ricynlee/femto/DEMO/readme.md

# Sound communication demo with femto/声音通信演示

***

This is a demo featuring a modified femto. The demo shows a case of sound communication, with OOK (on-off-keying) modulation.  
这是一个用魔改femto演示音频通信的项目，采用了OOK(开关键控)调制。  

***

Please vide the video below for a general introduction of femto and the demo.  
请点击下面的链接观看femto和演示项目简介。  

[Intro in Chinese/简介](https://www.bilibili.com/video/BV1J44y1s77Q)
