ricynlee/femto/(threads)

Thread 1 (2022-03-06):

Add trap support

ricynlee, 2022-03-06:
**Traps**, arroding to RISC-V privilege spec, are categorized into **interrupts** and **exceptions**, and there are internal/external interrupts.
As *femto* is a minimalist MCU, I think it's perfect to implement external interrupts only.
Faults may lead to a reset or halt.
No internal timer is to be implemented but there will be an external one.

ricynlee, 2022-05-08:
Interrupt support added. No exception support yet. Later debug exception will be implemented, but nothing else.

Closed 2022-05-08.
