ricynlee/femto/rtl/fpga/constraints/io.xdc

## Clock signal 12 MHz
set_property -dict {PACKAGE_PIN L17 IOSTANDARD LVCMOS33} [get_ports sysclk]
# add the timing description above if no clocking modules are used in the design

## NOR PULL
# set_property PULLUP true [get_ports {qspi_sio[3]}]
# set_property PULLUP true [get_ports {qspi_sio[2]}]
# set_property PULLUP true [get_ports {qspi_sio[1]}]
# set_property PULLUP true [get_ports {qspi_sio[0]}]

## QSPI NOR
# set_property -dict {PACKAGE_PIN E19 IOSTANDARD LVCMOS33} [get_ports qspi_sck]
# set_property -dict {PACKAGE_PIN K19 IOSTANDARD LVCMOS33} [get_ports qspi_csb]
# set_property -dict {PACKAGE_PIN D18 IOSTANDARD LVCMOS33} [get_ports {qspi_sio[0]}]
# set_property -dict {PACKAGE_PIN D19 IOSTANDARD LVCMOS33} [get_ports {qspi_sio[1]}]
# set_property -dict {PACKAGE_PIN G18 IOSTANDARD LVCMOS33} [get_ports {qspi_sio[2]}]
# set_property -dict {PACKAGE_PIN F18 IOSTANDARD LVCMOS33} [get_ports {qspi_sio[3]}]

## DSPI NOR
set_property -dict { PACKAGE_PIN H17   IOSTANDARD LVCMOS33 } [get_ports {qspi_sio[0]}]
set_property -dict { PACKAGE_PIN H19   IOSTANDARD LVCMOS33 } [get_ports {qspi_sio[1]}]
set_property -dict { PACKAGE_PIN J19   IOSTANDARD LVCMOS33 } [get_ports qspi_sck]
set_property -dict { PACKAGE_PIN K18   IOSTANDARD LVCMOS33 } [get_ports qspi_csb]
set_property -dict { PACKAGE_PIN G17   IOSTANDARD LVCMOS33 } [get_ports {qspi_sio[2]}]; # place holder
set_property -dict { PACKAGE_PIN G19   IOSTANDARD LVCMOS33 } [get_ports {qspi_sio[3]}]; # place holder

## LEDs
set_property -dict {PACKAGE_PIN B17 IOSTANDARD LVCMOS33} [get_ports led_b]
set_property -dict {PACKAGE_PIN B16 IOSTANDARD LVCMOS33} [get_ports led_g]
set_property -dict {PACKAGE_PIN C17 IOSTANDARD LVCMOS33} [get_ports led_r]
# set_property -dict {PACKAGE_PIN C16 IOSTANDARD LVCMOS33} [get_ports fault]

## Buttons
set_property -dict {PACKAGE_PIN B18 IOSTANDARD LVCMOS33} [get_ports button]
set_property -dict {PACKAGE_PIN A18 IOSTANDARD LVCMOS33} [get_ports sysrst]

## UART
set_property -dict {PACKAGE_PIN J18 IOSTANDARD LVCMOS33} [get_ports uart_tx]
set_property -dict {PACKAGE_PIN J17 IOSTANDARD LVCMOS33} [get_ports uart_rx]

## Cellular RAM
set_property -dict {PACKAGE_PIN M18 IOSTANDARD LVCMOS33} [get_ports {sram_addr[0]}]
set_property -dict {PACKAGE_PIN M19 IOSTANDARD LVCMOS33} [get_ports {sram_addr[1]}]
set_property -dict {PACKAGE_PIN K17 IOSTANDARD LVCMOS33} [get_ports {sram_addr[2]}]
set_property -dict {PACKAGE_PIN N17 IOSTANDARD LVCMOS33} [get_ports {sram_addr[3]}]
set_property -dict {PACKAGE_PIN P17 IOSTANDARD LVCMOS33} [get_ports {sram_addr[4]}]
set_property -dict {PACKAGE_PIN P18 IOSTANDARD LVCMOS33} [get_ports {sram_addr[5]}]
set_property -dict {PACKAGE_PIN R18 IOSTANDARD LVCMOS33} [get_ports {sram_addr[6]}]
set_property -dict {PACKAGE_PIN W19 IOSTANDARD LVCMOS33} [get_ports {sram_addr[7]}]
set_property -dict {PACKAGE_PIN U19 IOSTANDARD LVCMOS33} [get_ports {sram_addr[8]}]
set_property -dict {PACKAGE_PIN V19 IOSTANDARD LVCMOS33} [get_ports {sram_addr[9]}]
set_property -dict {PACKAGE_PIN W18 IOSTANDARD LVCMOS33} [get_ports {sram_addr[10]}]
set_property -dict {PACKAGE_PIN T17 IOSTANDARD LVCMOS33} [get_ports {sram_addr[11]}]
set_property -dict {PACKAGE_PIN T18 IOSTANDARD LVCMOS33} [get_ports {sram_addr[12]}]
set_property -dict {PACKAGE_PIN U17 IOSTANDARD LVCMOS33} [get_ports {sram_addr[13]}]
set_property -dict {PACKAGE_PIN U18 IOSTANDARD LVCMOS33} [get_ports {sram_addr[14]}]
set_property -dict {PACKAGE_PIN V16 IOSTANDARD LVCMOS33} [get_ports {sram_addr[15]}]
set_property -dict {PACKAGE_PIN W16 IOSTANDARD LVCMOS33} [get_ports {sram_addr[16]}]
set_property -dict {PACKAGE_PIN W17 IOSTANDARD LVCMOS33} [get_ports {sram_addr[17]}]
set_property -dict {PACKAGE_PIN V15 IOSTANDARD LVCMOS33} [get_ports {sram_addr[18]}]
set_property -dict {PACKAGE_PIN W15 IOSTANDARD LVCMOS33} [get_ports {sram_data[0]}]
set_property -dict {PACKAGE_PIN W13 IOSTANDARD LVCMOS33} [get_ports {sram_data[1]}]
set_property -dict {PACKAGE_PIN W14 IOSTANDARD LVCMOS33} [get_ports {sram_data[2]}]
set_property -dict {PACKAGE_PIN U15 IOSTANDARD LVCMOS33} [get_ports {sram_data[3]}]
set_property -dict {PACKAGE_PIN U16 IOSTANDARD LVCMOS33} [get_ports {sram_data[4]}]
set_property -dict {PACKAGE_PIN V13 IOSTANDARD LVCMOS33} [get_ports {sram_data[5]}]
set_property -dict {PACKAGE_PIN V14 IOSTANDARD LVCMOS33} [get_ports {sram_data[6]}]
set_property -dict {PACKAGE_PIN U14 IOSTANDARD LVCMOS33} [get_ports {sram_data[7]}]
set_property -dict {PACKAGE_PIN P19 IOSTANDARD LVCMOS33} [get_ports sram_oe_bar]
set_property -dict {PACKAGE_PIN R19 IOSTANDARD LVCMOS33} [get_ports sram_we_bar]
set_property -dict {PACKAGE_PIN N19 IOSTANDARD LVCMOS33} [get_ports sram_ce_bar]
