ricynlee/femto/rtl/fpga/constraints/config.xdc

# configuration related
set_property BITSTREAM.CONFIG.UNUSEDPIN pullnone [current_design]
set_property BITSTREAM.CONFIG.SPI_BUSWIDTH 4 [current_design]
set_property CONFIG_VOLTAGE 3.3 [current_design]
set_property CFGBVS VCCO [current_design]
