ricynlee/femto/rtl/mcu/rst/rst.v

`include "femto.vh"
`include "timescale.vh"

module rst_controller (
    input wire  clk,

    input wire                  rst_ib, // lo active
    output wire[`RST_WIDTH-1:0] rst_ob, // lo active

    input wire            soc_fault,
    input wire[7:0]       soc_fault_cause,
    input wire[`XLEN-1:0] soc_fault_addr,

    input wire[$clog2(`RST_SIZE)-1:0]   addr,
    input wire                          w_rb,
    input wire[`BUS_ACC_WIDTH-1:0]      acc,
    output reg[`BUS_WIDTH-1:0]          rdata,
    input wire[`BUS_WIDTH-1:0]          wdata,
    input wire                          req,
    output wire                         resp,
    output wire                         fault
);
    /*
     * Register map
     *  Name   | Address | Size | Access | Note
     *  RST    | 0       | 2    | W      | -
     *  CAUSE  | 2       | 2    | R      | -
     *  INFO   | 4       | 4    | RW     | Addr upon fault or SW-defined message
     *
     * RST
     *  (15:1) | RESET(0)
     * CAUSE
     *  (15:8) | CAUSE(7:0)
     */

    // fault generation
    wire invld_addr = (addr != 0) && (addr != 2) && (addr != 4);
    wire invld_acc  = (addr==4) ? (acc != `BUS_ACC_4B) : (acc != `BUS_ACC_2B);
    wire invld_wr   = w_rb ? addr[2:1]==2'd1 : addr[2:1]==2'd0;

    wire invld      = |{invld_addr,invld_acc,invld_wr};
    assign fault    = req & invld;

    // rst info
    reg[7:0]       rst_cause = `RST_CAUSE_POR;
    reg[`XLEN-1:0] rst_info;
    always @ (posedge clk) begin
        if (~rst_ib) begin
            rst_cause <= `RST_CAUSE_HW;
            // do not touch rst_info here so sw can set it at key points
            // in this way sw knows at which phase hw rst occurs
        end else if (req && ~invld && w_rb) begin
            if (addr==0 && wdata[0])
                rst_cause <= `RST_CAUSE_SW;
            else if (addr==4)
                rst_info <= wdata;
        end else if (soc_fault) begin
            rst_cause <= soc_fault_cause;
            rst_info <= soc_fault_addr;
        end
    end

    // resp generation
    reg resp_r = 1'b0; // initially no resp (FPGA synthesizable)
    assign resp = resp_r;
    always @ (posedge clk) begin
        resp_r <= req & ~invld;
        if (req & ~invld) begin
            if (addr[1]) // CAUSE
                rdata[15:0] <= {8'd0, rst_cause};
            else if (addr[2]) // INFO
                rdata <= rst_info;
        end
    end

    // reset generation
    reg [`RST_WIDTH-1:0] rst_drv = {`RST_WIDTH{1'b0}}; // initially POR (FPGA synthesizable)
    assign rst_ob = rst_drv;

    always @ (posedge clk) begin
        if (~rst_ib) begin // external reset input: highest priority
            rst_drv <= {`RST_WIDTH{1'b0}};
        end else if (req && ~invld && w_rb && addr==0 && wdata[0]) begin
            rst_drv <= {`RST_WIDTH{1'b0}};
        end else if (soc_fault) begin
            rst_drv <= {`RST_WIDTH{1'b0}};
        end else begin
            rst_drv <= {`RST_WIDTH{1'b1}};
        end
    end
endmodule
