ricynlee/femto/project/femto.srcs/sources_1/ip/clk_gen/clk_gen_stub.v

// Copyright 1986-2018 Xilinx, Inc. All Rights Reserved.
// --------------------------------------------------------------------------------
// Tool Version: Vivado v.2018.2 (win64) Build 2258646 Thu Jun 14 20:03:12 MDT 2018
// Date        : Sat Oct  9 16:08:51 2021
// Host        : NXL53319 running 64-bit major release  (build 9200)
// Command     : write_verilog -force -mode synth_stub D:/femto/project/femto.srcs/sources_1/ip/clk_gen/clk_gen_stub.v
// Design      : clk_gen
// Purpose     : Stub declaration of top-level module interface
// Device      : xc7a35tcpg236-1
// --------------------------------------------------------------------------------

// This empty module with port declaration file causes synthesis tools to infer a black box for IP.
// The synthesis directives are for Synopsys Synplify support to prevent IO buffer insertion.
// Please paste the declaration into a Verilog source file or add the file as an additional source.
module clk_gen(clk_out, clk_in)
/* synthesis syn_black_box black_box_pad_pin="clk_out,clk_in" */;
  output clk_out;
  input clk_in;
endmodule
