ricynlee/femto/rtl/sim/periph/MX25U51245G.v

// *============================================================================================== 
// *
// *   MX25U51245G.v - 512M-BIT CMOS Serial Flash Memory
// *
// *           COPYRIGHT 2021 Macronix International Co., Ltd.
// *
// * Security Level: Macronix Proprietary
// *----------------------------------------------------------------------------------------------
// * Environment  : Cadence NC-Verilog
// * Reference Doc: MX25U51245G REV.1.3,JUL.17,2020
// * Creation Date: @(#)$Date: 2021/06/08 10:50:57 $
// * Version      : @(#)$Revision: 1.17 $
// * Description  : There is only one module in this file
// *                module MX25U51245G->behavior model for the 512M-Bit flash
// *----------------------------------------------------------------------------------------------
// * Note 1:model can load initial flash data from file when parameter Init_File = "xxx" was defined; 
// *        xxx: initial flash data file name;default value xxx = "none", initial flash data is "FF".
// * Note 2:power setup time is tVSL = 1500_000 ns, so after power up, chip can be enable.
// * Note 3:because it is not checked during the Board system simulation the tCLQX timing
// *        is not inserted to the read function flow temporarily.
// * Note 4:more than one values (min. typ. max. value) are defined for some AC parameters in the
// *        datasheet, but only one of them is selected in the behavior model, e.g. program and
// *        erase cycle time is typical value. For the detailed information of the parameters,
// *        please refer to datasheet and contact with Macronix.
// * Note 5:If you have any question and suggestion, please send your mail to following email address :
// *                                    flash_model@mxic.com.tw
// *============================================================================================== 
// * timescale define
// *============================================================================================== 
`timescale 1ns / 100ps

`define MX25U51245GM 16SOP
//`define MX25U51245GZ4 8WSON
//`define MX25U51245GXD 24BALL


// *============================================================================================== 
// * product parameter define
// *============================================================================================== 

    /*----------------------------------------------------------------------*/
    /* all the parameters users may need to change                          */
    /*----------------------------------------------------------------------*/
        `define Type_0A  //for  non-password protection mode
        //`define Type_00  //for password protection mode

        `define File_Name         "none"         // Flash data file name for normal array
        `define File_Name_Secu    "none"         // Flash data file name for security region
        `define File_Name_SFDP    "none"         // Flash data file name for SFDP region
        `define VSecur_Reg1_0     2'b00          // security register[1:0]
        `define VSecur_Reg7       1'b0           // security register[7]
        `define VStatus_Reg7_2    6'b0           // status register[7:2] are non-volatile bits
        `define VLock_Reg         16'hffff       // lock register
        `define CR_Default4_0     5'b00111       // configuration register default value
        `define VPwd_Reg          64'hffff_ffff_ffff_ffff           // password register
        `define VFB_Reg           32'hffff_ffff  // fast boot register

        `ifdef MX25U51245GM
                `define Vtclqv 6    //30pf:8ns, 15pf:6ns, 10pf:5ns.
        `elsif MX25U51245GZ4
                `define Vtclqv 6  //30pf:8ns, 15pf:6ns, 10pf:5ns.
        `elsif MX25U51245GXD
                `define Vtclqv 5  //30pf:5ns, 15pf:5ns, 10pf:5ns.
        `endif
    /*----------------------------------------------------------------------*/
    /* Define controller STATE                                              */
    /*----------------------------------------------------------------------*/
        `define         STANDBY_STATE           0
        `define         CMD_STATE               1
        `define         BAD_CMD_STATE           2
        `define         FAST_BOOT_STATE         3

module MX25U51245G( SCLK, 
                    CS, 
                    SI, 
                    SO, 
                    WP, 
`ifdef MX25U51245GM
                    RESET,
`elsif MX25U51245GXD
                    RESET,
`endif
                    SIO3 );

// *============================================================================================== 
// * Declaration of ports (input, output, inout)
// *============================================================================================== 
    input  SCLK;    // Signal of Clock Input
    input  CS;      // Chip select (Low active)
    inout  SI;      // Serial Input/Output SIO0
    inout  SO;      // Serial Input/Output SIO1
    inout  WP;      // Hardware write protection or Serial Input/Output SIO2
`ifdef MX25U51245GM
    input  RESET;   // Hardware Reset Pin, Active Low
`elsif MX25U51245GXD
    input  RESET;   // Hardware Reset Pin, Active Low
`endif
    inout  SIO3;    // Serial Input/Output SIO3

// *============================================================================================== 
// * Declaration of parameter (parameter)
// *============================================================================================== 
    /*----------------------------------------------------------------------*/
    /* Density STATE parameter                                              */                  
    /*----------------------------------------------------------------------*/
    parameter   A_MSB           = 25,            
                TOP_Add         = 26'h1ff,
                A_MSB_OTP       = 9,                
                Secur_TOP_Add   = 10'h3ff,
                Sector_MSB      = 13,
                A_MSB_SFDP      = 8,
                SFDP_TOP_Add    = 9'h1ff,
                Buffer_Num      = 256,
                Block_MSB       = 9,
                Block_NUM       = 1024;
  
    /*----------------------------------------------------------------------*/
    /* Define ID Parameter                                                  */
    /*----------------------------------------------------------------------*/
    parameter   ID_MXIC         = 8'hc2,
                ID_Device       = 8'h3a,
                Memory_Type     = 8'h25,
                Memory_Density  = 8'h3a;

    /*----------------------------------------------------------------------*/
    /* Define Initial Memory File Name                                      */
    /*----------------------------------------------------------------------*/
    parameter   Init_File       = `File_Name;      // initial flash data
    parameter   Init_File_Secu  = `File_Name_Secu; // initial flash data for security
    parameter   Init_File_SFDP  = `File_Name_SFDP;  // initial flash data for SFDP

    /*----------------------------------------------------------------------*/
    /* AC Characters Parameter                                              */
    /*----------------------------------------------------------------------*/
    parameter   tSHQZ           = 8,        // CS High to SO Float Time [ns]
                tCLQV           = `Vtclqv,  // Clock Low to Output Valid
                tCLQX           = 1,        // Output hold time
                tCEH            = 20,         // CS# high time after program
                tPGBUF_RST      = 40,   // Page buffer reset time
                tBP             = 25_000,      //  Byte program time
                tSE             = 25_000_000,      // Sector erase time  
                tBE             = 220_000,      // Block erase time
                tBE32           = 150_000_000,    // Block 32KB erase time
                tCE             = 150_000,      // unit is ms instead of ns  
                tPP             = 150_000,      // Program time
                tWR_END         = 2_000,          // the time of write operation going to end, suspend not work 
                tW              = 40_000_000,       // Write Status time 
                tWPS            = 25_000,     // Write Protection Select time
                tWREAW          = 40,   // Write extended address register time
                tWRFBR          = 25_000,   // Write fast boot register time
                tWRPASS         = 25_000,  // Write password register time
                tPASSULK        = 2_000, // Right password check time
                tPASSULK_FAIL   = 150_000,    // Password check fail waiting time
                tREADY2_P       = 310_000,  // hardware reset recovery time for pgm
                tREADY2_SE      = 12_000_000,  // hardware reset recovery time for sector ers
                tREADY2_BE      = 25_000_000,  // hardware reset recovery time for block ers
                tREADY2_CE      = 1000_000_000,  // hardware reset recovery time for chip ers
                tREADY2_R       = 40_000,  // hardware reset recovery time for read
                tREADY2_D       = 40_000,  // hardware reset recovery time for instruction decoding phase
                tREADY2_W       = 40_000_000,  // hardware reset recovery time for WRSR
                tVSL            = 5;     // Time delay to chip select allowed

    parameter   tPGM_CHK        = 2_000,   // 2 us
                tERS_CHK        = 100_000;   // 100 us
    parameter   tESL            = 25_000,       // delay after sector erase suspend command
                tPSL            = 25_000,       // delay after sector program suspend command
                tPRS            = 100_000,      // latency between program resume and next suspend
                tERS            = 400_000;      // latency between erase resume and next suspend

    /*----------------------------------------------------------------------*/
    /* Internal counter parameter                                           */
    /*----------------------------------------------------------------------*/
    parameter  Clock             = 50,      // Internal clock cycle = 100ns
               ERS_Count_BE32K   = tBE32 / (Clock*2) / 20,   // Internal clock cycle = 2us
               ERS_Count_SE      = tSE / (Clock*2) / 20,     // Internal clock cycle = 2us
               ERS_Count_BE      = tBE / (Clock*2) / 20,     // Internal clock cycle = 2us
               Echip_Count       = tCE  / (Clock*2) * 2000; 


    specify
        specparam   tSCLK   = 6,    // Clock Cycle Time [ns]
                    fSCLK   = 166,    // Clock Frequence except READ instruction
                    tRSCLK  = 15.2,   // Clock Cycle Time for READ instruction
                    fRSCLK  = 66,   // Clock Frequence for READ instruction
                    tCH     = 2.71,      // Clock High Time (min) [ns]
                    tCL     = 2.71,      // Clock Low  Time (min) [ns]
                    tCH_R   = 7,      // Clock High Time (min) [ns]
                    tCL_R   = 7,      // Clock Low  Time (min) [ns]
                    tCH_4PP = 2.71,      // Clock High Time (min) [ns]
                    tCL_4PP = 2.71,      // Clock Low  Time (min) [ns]
                    tSLCH   = 3,    // CS# Active Setup Time (relative to SCLK) (min) [ns]
                    tCHSL   = 4,    // CS# Not Active Hold Time (relative to SCLK)(min) [ns]
                    tSHSL_R = 7,    // CS High Time for read instruction (min) [ns]
                    tSHSL_W = 30,    // CS High Time for write instruction (min) [ns]
                    tDVCH   = 2,    // SI Setup Time (min) [ns]
                    tCHDX   = 2,    // SI Hold  Time (min) [ns]
                    tCHSH   = 3,    // CS# Active Hold Time (relative to SCLK) (min) [ns]
                    tSHCH   = 3,    // CS# Not Active Setup Time (relative to SCLK) (min) [ns]
                    tWHSL   = 20,    // Write Protection Setup Time                
                    tSHWL   = 100,    // Write Protection Hold  Time
   
                    tTSCLK  = 11.9,    // Clock Cycle Time for 2XI/O READ instruction
                    tTSCLK2 = 9.6,    // Clock Cycle Time for 2XI/O READ instruction
                    tTSCLK3 = 7.5,    // Clock Cycle Time for 2XI/O READ instruction
                    tTSCLK4 = 6.0,    // Clock Cycle Time for 2XI/O READ instruction
                    fTSCLK  = 84,    // Clock Frequence for 2XI/O READ instruction
                    fTSCLK2 = 104,    // Clock Frequence for 2XI/O READ instruction
                    fTSCLK3 = 133,    // Clock Frequence for 2XI/O READ instruction
                    fTSCLK4 = 166,    // Clock Frequence for 2XI/O READ instruction

                    tQSCLK  = 11.9,    // Clock Cycle Time for 4XI/O READ instruction
                    tQSCLK2 = 14.3,    // Clock Cycle Time for 4XI/O READ instruction
                    tQSCLK3 = 9.6,    // Clock Cycle Time for 4XI/O READ instruction
                    tQSCLK4 = 7.5,    // Clock Cycle Time for 4XI/O READ instruction
                    fQSCLK  = 84,    // Clock Frequence for 4XI/O READ instruction
                    fQSCLK2 = 70,  // Clock Frequence for 4XI/O READ instruction
                    fQSCLK3 = 104,  // Clock Frequence for 4XI/O READ instruction
                    fQSCLK4 = 133,  // Clock Frequence for 4XI/O READ instruction

                    tFSCLK   = 7.5,    // Clock Cycle Time for FASTREAD instruction
                    tFSCLK2  = 7.5,    // Clock Cycle Time for FASTREAD instruction
                    tFSCLK3  = 7.5,    // Clock Cycle Time for FASTREAD instruction
                    tFSCLK4  = 6.0,    // Clock Cycle Time for FASTREAD instruction
                    fFSCLK   = 133,   // Clock Frequence for FASTREAD instruction
                    fFSCLK2  = 133,   // Clock Frequence for FASTREAD instruction
                    fFSCLK3  = 133,   // Clock Frequence for FASTREAD instruction
                    fFSCLK4  = 166,   // Clock Frequence for FASTREAD instruction

                    tFDSCLK   = 7.5,    // Clock Cycle Time for DREAD instruction
                    tFDSCLK2  = 7.5,    // Clock Cycle Time for DREAD instruction
                    tFDSCLK3  = 7.5,    // Clock Cycle Time for DREAD instruction
                    tFDSCLK4  = 6.0,    // Clock Cycle Time for DREAD instruction
                    fFDSCLK   = 133,   // Clock Frequence for DREAD instruction
                    fFDSCLK2  = 133,   // Clock Frequence for DREAD instruction
                    fFDSCLK3  = 133,   // Clock Frequence for DREAD instruction
                    fFDSCLK4  = 166,   // Clock Frequence for DREAD instruction

                    tFQSCLK   = 7.5,    // Clock Cycle Time for QREAD instruction
                    tFQSCLK2  = 9.6,    // Clock Cycle Time for QREAD instruction
                    tFQSCLK3  = 7.5,    // Clock Cycle Time for QREAD instruction
                    tFQSCLK4  = 6.0,    // Clock Cycle Time for QREAD instruction
                    fFQSCLK   = 133,    // Clock Frequence for QREAD instruction
                    fFQSCLK2  = 104,   // Clock Frequence for QREAD instruction
                    fFQSCLK3  = 133,   // Clock Frequence for QREAD instruction
                    fFQSCLK4  = 166,   // Clock Frequence for QREAD instruction

                    tQDTRSCLK   = 19.2,    // Clock Cycle Time for FASTDDR4READ instruction
                    tQDTRSCLK2   = 23.8,    // Clock Cycle Time for FASTDDR4READ instruction
                    tQDTRSCLK3   = 15.1,    // Clock Cycle Time for FASTDDR4READ instruction
                    tQDTRSCLK4   = 9.8,    // Clock Cycle Time for FASTDDR4READ instruction
                    fQDTRSCLK   = 52,   // Clock Frequence for FASTDDR4READ instruction
                    fQDTRSCLK2   = 42,   // Clock Frequence for FASTDDR4READ instruction
                    fQDTRSCLK3   = 66,   // Clock Frequence for FASTDDR4READ instruction
                    fQDTRSCLK4   = 102,   // Clock Frequence for FASTDDR4READ instruction

                    tFBSCLK   = 14.3,    // Clock Cycle Time for Fast Boot Read 
                    tFBSCLK2  = 11.9,   // Clock Cycle Time for Fast Boot Read 
                    tFBSCLK3  = 9.6,   // Clock Cycle Time for Fast Boot Read 
                    tFBSCLK4  = 7.5,   // Clock Cycle Time for Fast Boot Read
                    fFBSCLK   = 70,    // Clock Frequence for Fast Boot Read 
                    fFBSCLK2  = 84,   // Clock Frequence for Fast Boot Read 
                    fFBSCLK3  = 104,   // Clock Frequence for Fast Boot Read 
                    fFBSCLK4  = 133,   // Clock Frequence for Fast Boot Read 

                    tRLRH   = 10_000,   // hardware reset pulse
                    tRS     = 15,     // reset setup time
                    tRH     = 15,     // reset hold time
                    tRHSL   = 10_000,  // RESET# high before CS# low
                    tDP     = 10_000,
                    tRES1   = 30_000,
                    tRES2   = 30_000;

     endspecify

    /*----------------------------------------------------------------------*/
    /* Define Command Parameter                                             */
    /*----------------------------------------------------------------------*/
    parameter   WREN        = 8'h06, // WriteEnable   
                WRDI        = 8'h04, // WriteDisable  
                RDSR        = 8'h05, // ReadStatus
                RDCR        = 8'h15, // read configuration register       
                WRSR        = 8'h01, // WriteStatus
                RDID        = 8'h9F, // ReadID
                RES         = 8'hab, // ReadElectricID
                REMS        = 8'h90, // ReadElectricManufacturerDeviceID
                QPIID       = 8'haf, // QPI ID read
                SFDP_READ   = 8'h5a, // enter SFDP read mode
                ENSO        = 8'hb1, // Enter secured OTP;
                EXSO        = 8'hc1, // Exit  secured OTP;
                READ1X      = 8'h03, // ReadData
                READ4B      = 8'h13, // ReadData by 4 byte address
                FASTREAD1X  = 8'h0b, // FastReadData
                FASTREAD4B  = 8'h0c, // FastReadData by 4 byte address
                READ2X      = 8'hbb, // 2X Read
                READ2X4B    = 8'hbc, // 2X Read by 4 byte address
                DREAD       = 8'h3b, // Fastread dual output;
                DREAD4B     = 8'h3c, // Fastread dual output by 4 byte address;
                READ4X      = 8'heb, // 4XI/O Read;
                READ4X4B    = 8'hec, // 4XI/O Read by 4 byte address;
                QREAD       = 8'h6b, // Fastread quad output;
                QREAD4B     = 8'h6c, // Fastread quad output by 4 byte address;
                DDRREAD4X   = 8'hed, // Quad DDR read 4XI/O Read;
                DDRREAD4X4B   = 8'hee, // Quad DDR read 4XI/O Read 4byte;
                PP          = 8'h02, // PageProgram
                PP4B        = 8'h12, // PageProgram by 4 byte address
                FIOPGM0     = 8'h38, // 4I Page Pgm load address and data all 4io
                FIOPGM04B   = 8'h3e, // 4I Page Pgm load address and data all 4io by 4 byte address
                SE          = 8'h20, // SectorErase
                SE4B        = 8'h21, // SectorErase by 4 byte address
                BE32K       = 8'h52, // 32k block erase
                BE32K4B     = 8'h5c, // 32k block erase by 4 byte address
                BE          = 8'hd8, // BlockErase
                BE4B        = 8'hdc, // BlockErase by 4 byte address
                CE1         = 8'h60, // ChipErase
                CE2         = 8'hc7, // ChipErase
                EQIO        = 8'h35, // enable quad I/O
                RSTQIO      = 8'hf5, // reset quad I/O
                EN4B        = 8'hb7, // enter 4-byte mode
                EX4B        = 8'he9, // exit 4-byte mode
                SBL         = 8'hc0, // set burst length
                RDSCUR      = 8'h2b, // Read  security  register;
                WRSCUR      = 8'h2f, // Write security  register;
                RDEAR       = 8'hc8, // Read  extended address register;
                WREAR       = 8'hc5, // Write extended address register;
                RSTEN       = 8'h66, // reset enable
                RST         = 8'h99, // reset memory
                NOP         = 8'h00, // no operation
                DP          = 8'hb9, // DeepPowerDown
                RDP         = 8'hab, // ReleaseFromDeepPowerDown 
                WPSEL       = 8'h68, // write protection selection
                WRLR        = 8'h2c, // write lock register
                RDLR        = 8'h2d, // read lock register
                WRPASS      = 8'h28, // Write password register;
                PASSULK     = 8'h29, // Password unlock;
                RDPASS      = 8'h27, // Read password register;
                WRDPB       = 8'he1, // DPB bit write
                RDDPB       = 8'he0, // DPB bit read
                GBLK        = 8'h7e, // gang block lock
                GBULK       = 8'h98, // gang block unlock         
                RDFBR       = 8'h16, // read fast boot register
                WRFBR       = 8'h17, // write fast boot register
                ESFBR       = 8'h18, // erase fast boot register
                WRSPB       = 8'he3, // SPB bit program
                ESSPB       = 8'he4, // SPB bit erase
                RDSPB       = 8'he2, // SPB bit read
                SUSP        = 8'hb0, // write suspend
                SUSP1       = 8'h75, // write suspend
                RESU        = 8'h30, // write resume
                RESU1       = 8'h7a; // write resume

    /*----------------------------------------------------------------------*/
    /* Declaration of internal-signal                                       */
    /*----------------------------------------------------------------------*/
    reg  [7:0]           ARRAY[0:TOP_Add];  // memory array
    reg  [7:0]           Secur_ARRAY[0:Secur_TOP_Add]; // Secured OTP
    reg  [7:0]           SFDP_ARRAY[0:SFDP_TOP_Add];
    reg  [7:0]           Status_Reg;        // Status Register
    reg  [7:0]           Status_Tmp_Reg;    
    reg  [7:0]           CMD_BUS;
    reg  [31:0]          SI_Reg;            // temp reg to store serial in
    reg  [31:0]          SI_Reg_DDR;
    reg  [7:0]           Dummy_A[0:255];    // page size
    reg  [A_MSB:0]       Address;           
    reg  [Sector_MSB:0]  Sector;          
    reg  [Block_MSB:0]   Block;    
    reg  [Block_MSB+1:0] Block2;           
    reg  [2:0]           STATE;
    reg  [7:0]           Prea_Reg;

    reg  [7:0]           CR;
    reg  [7:0]           Secur_Reg;         // security register
    reg  [7:0]           EA_Reg;            // extended address register
    reg  [15:0]          Lock_Reg;          // lock register
    reg  [63:0]          Pwd_Reg;           // password register
    reg  [31:0]          FB_Reg;            // Fast Boot register

    reg  [15:0]          SPB_Reg_TOP; 
    reg  [15:0]          SPB_Reg_BOT; 
    reg  [Block_NUM - 2:1] SPB_Reg; 
    reg  [15:0]           DPB_Reg_TOP; 
    reg  [15:0]           DPB_Reg_BOT;
    reg  [Block_NUM - 2:1] DPB_Reg;

    wire [15:0] SEC_Pro_Reg_TOP;
    wire [15:0] SEC_Pro_Reg_BOT;
    wire [Block_NUM - 2:1] SEC_Pro_Reg;

    
    reg     Chip_EN;
    reg     DP_Mode;        // deep power down mode
    reg     Read_Mode;
    reg     Read_1XIO_Mode;
    reg     Read_1XIO_Chk;

    reg     FAST_BOOT_Mode;
    reg     FAST_BOOT_Chk;

    reg     tDP_Chk;
    reg     tRES1_Chk;
    reg     tRES2_Chk;

    reg     RDID_Mode;
    reg     RDSR_Mode;
    reg     RDSCUR_Mode;
    reg     RDEAR_Mode;
    reg     RDLR_Mode;
    reg     RDFBR_Mode;
    reg     RDPASS_Mode;
    reg     RDDPB_Mode;
    reg     RDSPB_Mode;
    reg     FastRD_1XIO_Mode;   
    reg     FastRD_1XIO_Chk;    
    reg     PP_1XIO_Mode;
    reg     SE_4K_Mode;
    reg     BE_Mode;
    reg     BE32K_Mode;
    reg     BE64K_Mode;
    reg     CE_Mode;
    reg     WRSR_Mode;
    reg     WRSR2_Mode;
    reg     WRLR_Mode;
    reg     WRPASS_Mode;
    reg     PASSULK_Mode;
    reg     WRFBR_Mode;
    reg     WRDPB_Mode;
    reg     ESFBR_Mode;
    reg     WRSPB_Mode;
    reg     ESSPB_Mode;
    reg     RES_Mode;
    reg     REMS_Mode;
    reg     RDCR_Mode;

    reg     EN4B_Mode;

    reg     ENDDR4XIO_Read_Mode;
    reg     DDRRead_4XIO_Mode;
    reg     DDRRead_4XIO_ModeX;
    reg     DDRRead_4XIO_Mode_4B;
    reg     DDR_Read_Mode_IN;
    reg     Set_4XIO_DDR_Enhance_Mode;

    reg     SCLK_EN;
    reg     SO_OUT_EN;   // for SO
    reg     SI_IN_EN;    // for SI
    reg     SFDP_Mode;
    reg     RST_CMD_EN;
    reg     WRSCUR_Mode;
    reg     WREAR_Mode;
    reg     WR_WPSEL_Mode;
    reg     EN_Burst;
    reg     Susp_Ready;
    reg     Susp_Trig;
    reg     Susp_Inval_Mode;
    reg     Resume_Trig;
    reg     During_Susp_Wait;
    reg     ERS_CLK;                  // internal clock register for erase timer
    reg     PGM_CLK;                  // internal clock register for program timer
    reg     WR2Susp;

    reg     EN_Boot;
    reg     ADD_4B_Mode;

    wire    CS_INT;
    wire    WP_B_INT;
    wire    RESETB_INT;
    wire    SCLK; 
    wire    WIP;
    wire    ESB;
    wire    PSB;
    wire    EPSUSP;
    wire    WEL;
    wire    SRWD;
    wire    PWDMLB;
    wire    SPBMLB;
    wire    SPBLB;
    wire    SPBLKDN;
    wire    FBE;
    wire    Dis_CE, Dis_WRSR;  
    wire    WPSEL_Mode;
    wire    Norm_Array_Mode;
    wire    DDR_Read_Mode;
    wire    Pgm_Mode;
    wire    Ers_Mode;

    event   Resume_Event; 
    event   Susp_Event; 
    event   WRSR_Event; 
    event   WRLR_Event;
    event   WRFBR_Event; 
    event   WRPASS_Event; 
    event   PASSULK_Event; 
    event   SPBLK_Event; 
    event   WRDPB_Event; 
    event   WRSPB_Event; 
    event   ESSPB_Event; 
    event   ESFBR_Event; 
    event   BE_Event;
    event   SE_4K_Event;
    event   CE_Event;
    event   PP_Event;
    event   BE32K_Event;
    event   WRSCUR_Event;
    event   WREAR_Event;
    event   WPSEL_Event;
    event   GBLK_Event;
    event   GBULK_Event;
    event   RST_Event;
    event   RST_EN_Event;
    event   HDRST_Event;

    integer i;
    integer j;
    integer Bit; 
    integer Bit_Tmp; 
    integer Start_Add;
    integer End_Add;
    integer tWRSR;
    integer Burst_Length;
//    time    tRES;
    time    ERS_Time;
    time    tPP_Real;
    reg Read_SHSL;
    wire Write_SHSL;

    reg     Pagebuf_Rst;
    reg     Prea_OUT_EN1;
    reg     Prea_OUT_EN2;
    reg     Prea_OUT_EN4;

    reg     Secur_Mode;     // enter secured mode
    reg     Read_2XIO_Mode;
    reg     Read_2XIO_Chk;
    reg     Byte_PGM_Mode;          
    reg     SI_OUT_EN;   // for SI
    reg     SO_IN_EN;    // for SO
    reg     SIO0_Reg;
    reg     SIO1_Reg;
    reg     SIO2_Reg;
    reg     SIO3_Reg;
    reg     SIO0_Out_Reg;
    reg     SIO1_Out_Reg;
    reg     SIO2_Out_Reg;
    reg     SIO3_Out_Reg;
    reg     Read_4XIO_Mode;
    reg     READ4X_Mode;
    reg     READ4X_BOT_Mode;
    reg     READ4X4B_Mode;
    reg     Read_4XIO_Chk;
    reg     FastRD_2XIO_Mode;
    reg     FastRD_2XIO_Chk;
    reg     FastRD_4XIO_Mode;
    reg     FastRD_4XIO_Chk;
    reg     PP_4XIO_Mode;
    reg     PP_4XIO_Load;
    reg     PP_4XIO_Chk;
    reg     EN4XIO_Read_Mode;
    reg     Set_4XIO_Enhance_Mode;   
    reg     WP_OUT_EN;   // for WP pin
    reg     SIO3_OUT_EN; // for SIO3 pin
    reg     WP_IN_EN;    // for WP pin
    reg     SIO3_IN_EN;  // for SIO3 pin
    reg     ENQUAD;
    reg     During_RST_REC;
    wire    HPM_RD;
    wire    SIO3;
    wire    CR_00;
    wire    CR_01;
    wire    CR_10;
    wire    CR_11;
    assign CR_00 = !CR[7] && !CR[6];
    assign CR_01 = !CR[7] && CR[6];
    assign CR_10 = CR[7] && !CR[6];
    assign CR_11 = CR[7] && CR[6];

    /*----------------------------------------------------------------------*/
    /* initial variable value                                               */
    /*----------------------------------------------------------------------*/
    initial begin
        
        Chip_EN         = 1'b0;
        Secur_Reg       = {`VSecur_Reg7,5'b0_0000,`VSecur_Reg1_0};
        Status_Reg      = {`VStatus_Reg7_2,2'b00};
        CR              = {3'b000,`CR_Default4_0};
        Prea_Reg        = 8'b0011_0100;
        EA_Reg          = 8'b0000_0000;
        FB_Reg          = `VFB_Reg;
        Lock_Reg        = `VLock_Reg;
        Pwd_Reg         = `VPwd_Reg;
        SPB_Reg_TOP[15:0] = 16'h0000;
        SPB_Reg_BOT[15:0] = 16'h0000;
        SPB_Reg = 1'b0;
        reset_sm;
    end   

    task reset_sm; 
        begin
            During_RST_REC  = 1'b0;
            WRSCUR_Mode     = 1'b0;
            WREAR_Mode     = 1'b0;
            WR_WPSEL_Mode   = 1'b0;
            SIO0_Reg        = 1'b1;
            SIO1_Reg        = 1'b1;
            SIO2_Reg        = 1'b1;
            SIO3_Reg        = 1'b1;
            SIO0_Out_Reg    = SIO0_Reg;
            SIO1_Out_Reg    = SIO1_Reg;
            SIO2_Out_Reg    = SIO2_Reg;
            SIO3_Out_Reg    = SIO3_Reg;
            RST_CMD_EN      = 1'b0;
            ENQUAD          = 1'b0;
            Pagebuf_Rst     = 1'b0;
            Prea_OUT_EN1     = 1'b0;
            Prea_OUT_EN2     = 1'b0;
            Prea_OUT_EN4     = 1'b0;
            SO_OUT_EN       = 1'b0; // SO output enable
            SI_IN_EN        = 1'b0; // SI input enable
            CMD_BUS         = 8'b0000_0000;
            Address         = 0;
            i               = 0;
            j               = 0;
            Bit             = 0;
            Bit_Tmp         = 0;
            Start_Add       = 0;
            End_Add         = 0;
            DP_Mode         = 1'b0;
            SCLK_EN         = 1'b1;
            Read_Mode       = 1'b0;
            Read_1XIO_Mode  = 1'b0;
            Read_1XIO_Chk   = 1'b0;
            tDP_Chk         = 1'b0;
            tRES1_Chk       = 1'b0;
            tRES2_Chk       = 1'b0;

            FAST_BOOT_Mode  = 1'b0;
            FAST_BOOT_Chk  = 1'b0;

            RDID_Mode       = 1'b0;
            RDSR_Mode       = 1'b0;
            RDSCUR_Mode     = 1'b0;
            RDCR_Mode       = 1'b0;
            RDEAR_Mode      = 1'b0;
            RDLR_Mode       = 1'b0;
            RDFBR_Mode      = 1'b0;
            RDPASS_Mode     = 1'b0;
            RDDPB_Mode     = 1'b0;
            RDSPB_Mode     = 1'b0;

            EN4B_Mode = 1'b0;

            PP_1XIO_Mode    = 1'b0;
            SE_4K_Mode      = 1'b0;
            BE_Mode         = 1'b0;
            BE32K_Mode      = 1'b0;
            BE64K_Mode      = 1'b0;
            CE_Mode         = 1'b0;
            WRSR_Mode       = 1'b0;
            WRSR2_Mode      = 1'b0;
            WRLR_Mode       = 1'b0;
            WRPASS_Mode     = 1'b0;
            PASSULK_Mode    = 1'b0;
            WRFBR_Mode      = 1'b0;
            WRDPB_Mode      = 1'b0;
            ESFBR_Mode      = 1'b0;
            WRSPB_Mode      = 1'b0;
            ESSPB_Mode      = 1'b0;
            RES_Mode        = 1'b0;
            REMS_Mode       = 1'b0;
            Read_SHSL       = 1'b0;
            FastRD_1XIO_Mode  = 1'b0;
            FastRD_1XIO_Chk  = 1'b0;
            FastRD_2XIO_Mode  = 1'b0;
            FastRD_2XIO_Chk  = 1'b0;
            FastRD_4XIO_Mode  = 1'b0;
            FastRD_4XIO_Chk  = 1'b0;
            SI_OUT_EN       = 1'b0; // SI output enable
            SO_IN_EN        = 1'b0; // SO input enable
            Secur_Mode      = 1'b0;
            Read_2XIO_Mode  = 1'b0;
            Read_2XIO_Chk   = 1'b0;
            Byte_PGM_Mode   = 1'b0;
            WP_OUT_EN       = 1'b0; // for WP pin output enable
            SIO3_OUT_EN     = 1'b0; // for SIO3 pin output enable
            WP_IN_EN        = 1'b0; // for WP pin input enable
            SIO3_IN_EN      = 1'b0; // for SIO3 pin input enable
            Read_4XIO_Mode  = 1'b0;

            READ4X4B_Mode    = 1'b0;
            READ4X_Mode    = 1'b0;
            READ4X_BOT_Mode=1'b0;

            Read_4XIO_Chk   = 1'b0;
            PP_4XIO_Mode    = 1'b0;
            PP_4XIO_Load    = 1'b0;
            PP_4XIO_Chk     = 1'b0;
            EN4XIO_Read_Mode  = 1'b0;
            Set_4XIO_Enhance_Mode = 1'b0;
            SFDP_Mode = 1'b0;
            EN_Burst          = 1'b0;
            Burst_Length      = 8;
            Susp_Ready        = 1'b1;
            Susp_Trig         = 1'b0;
            Susp_Inval_Mode   = 1'b0;
            Resume_Trig       = 1'b0;
            During_Susp_Wait  = 1'b0;
            ERS_CLK           = 1'b0;
            PGM_CLK           = 1'b0;
            WR2Susp          = 1'b0;
            EN_Boot          = 1'b1;

            ADD_4B_Mode = 1'b0;

            EA_Reg          = 8'b0000_0000;
            DPB_Reg_TOP[15:0] = 16'hffff;
            DPB_Reg_BOT[15:0] = 16'hffff;
            DPB_Reg     = ~1'b0;

            ENDDR4XIO_Read_Mode = 1'b0;
            DDRRead_4XIO_Mode   = 1'b0;
            DDRRead_4XIO_ModeX  = 1'b0;
            DDRRead_4XIO_Mode_4B = 1'b0;
            DDR_Read_Mode_IN    = 1'b0;
            Set_4XIO_DDR_Enhance_Mode = 1'b0;
            Status_Tmp_Reg[5:2] = 4'hf;
            if (!Lock_Reg[2]) begin
                    Lock_Reg[6] = 0;
            end
        end
    endtask // reset_sm
    
    /*----------------------------------------------------------------------*/
    /* initial flash data                                                   */
    /*----------------------------------------------------------------------*/
    initial 
    begin : memory_initialize
        for ( i = 0; i <=  TOP_Add; i = i + 1 )
            ARRAY[i] = 8'hff; 
        if ( Init_File != "none" )
            $readmemh(Init_File,ARRAY) ;
        for( i = 0; i <=  Secur_TOP_Add; i = i + 1 ) begin
            Secur_ARRAY[i]=8'hff;
        end
        if ( Init_File_Secu != "none" )
            $readmemh(Init_File_Secu,Secur_ARRAY) ;
        for( i = 0; i <=  SFDP_TOP_Add; i = i + 1 ) begin
            SFDP_ARRAY[i] = 8'hff;
        end
        if ( Init_File_SFDP != "none" )
            $readmemh(Init_File_SFDP,SFDP_ARRAY) ;
        // define SFDP code
    end

// *============================================================================================== 
// * Input/Output bus operation 
// *============================================================================================== 
    assign   CS_INT   = ( During_RST_REC == 1'b0 && RESETB_INT == 1'b1 && Chip_EN ) ? CS : 1'b1;
    assign   WP_B_INT = (Status_Reg[6] == 1'b0 && ENQUAD == 1'b0) ? WP : 1'b1;
    assign   SO     = SO_OUT_EN ? SIO1_Out_Reg : 1'bz ;
    assign   SI     = SI_OUT_EN ? SIO0_Out_Reg : 1'bz ;
    assign   WP     = WP_OUT_EN   ? SIO2_Out_Reg : 1'bz ;
    assign   SIO3   = SIO3_OUT_EN ? SIO3_Out_Reg : 1'bz ;
`ifdef MX25U51245GM
    assign   RESETB_INT = (RESET === 1'b1 || RESET === 1'b0) ? RESET : 1'b1;
`elsif MX25U51245GXD
    assign   RESETB_INT = (RESET === 1'b1 || RESET === 1'b0) ? RESET : 1'b1;
`elsif MX25U51245GZ4
    assign   RESETB_INT = (Status_Reg[6] == 1'b0 && ENQUAD == 1'b0)? ((SIO3 === 1'b1 || SIO3 === 1'b0) ? SIO3 : 1'b1): 1'b1;
`endif

    /*----------------------------------------------------------------------*/
    /* output buffer                                                        */
    /*----------------------------------------------------------------------*/
    always @( SIO3_Reg or SIO2_Reg or SIO1_Reg or SIO0_Reg ) begin
        if ( SIO3_OUT_EN && WP_OUT_EN && SO_OUT_EN && SI_OUT_EN ) begin
            SIO3_Out_Reg <= #tCLQV SIO3_Reg;
            SIO2_Out_Reg <= #tCLQV SIO2_Reg;
            SIO1_Out_Reg <= #tCLQV SIO1_Reg;
            SIO0_Out_Reg <= #tCLQV SIO0_Reg;
        end
        else if ( SO_OUT_EN && SI_OUT_EN ) begin
            SIO1_Out_Reg <= #tCLQV SIO1_Reg;
            SIO0_Out_Reg <= #tCLQV SIO0_Reg;
        end
        else if ( SO_OUT_EN ) begin
            SIO1_Out_Reg <= #tCLQV SIO1_Reg;
        end
    end

// *============================================================================================== 
// * Finite State machine to control Flash operation
// *============================================================================================== 
    /*----------------------------------------------------------------------*/
    /* power on                                                             */
    /*----------------------------------------------------------------------*/
    initial begin 
        Chip_EN   <= #tVSL 1'b1;// Time delay to chip select allowed 
    end
    
    /*----------------------------------------------------------------------*/
    /* Command Decode                                                       */
    /*----------------------------------------------------------------------*/
    assign ESB      = Secur_Reg[3] ;
    assign PSB      = Secur_Reg[2] ;
    assign EPSUSP   = ESB | PSB ;
    assign WIP      = Status_Reg[0] ;
    assign WEL      = Status_Reg[1] ;
    assign SRWD     = Status_Reg[7] ;
    assign Dis_CE   = Status_Reg[5] == 1'b1 || Status_Reg[4] == 1'b1 ||
                      Status_Reg[3] == 1'b1 || Status_Reg[2] == 1'b1;
    assign HPM_RD   = EN4XIO_Read_Mode == 1'b1 || ENDDR4XIO_Read_Mode == 1'b1;  
    assign Norm_Array_Mode = ~Secur_Mode;
    assign Dis_WRSR = (WP_B_INT == 1'b0 && Status_Reg[7] == 1'b1) || (!Norm_Array_Mode);
    assign WPSEL_Mode = Secur_Reg[7];
    assign DDR_Read_Mode = DDRRead_4XIO_Mode;
    assign Pgm_Mode = PP_1XIO_Mode || PP_4XIO_Mode;
    assign Ers_Mode = SE_4K_Mode || BE_Mode;

    assign PWDMLB    = Lock_Reg[2] ;
    assign SPBMLB    = Lock_Reg[2] ;
    assign SPBLKDN   = Lock_Reg[6] ;

    assign FBE       = FB_Reg[0];

    assign SEC_Pro_Reg_TOP = SPB_Reg_TOP | DPB_Reg_TOP ;
    assign SEC_Pro_Reg_BOT = SPB_Reg_BOT | DPB_Reg_BOT ;
    assign SEC_Pro_Reg = SPB_Reg | DPB_Reg ;

    always @ ( negedge CS_INT ) begin
        if ( !EN_Boot || FBE ) begin
            SI_IN_EN = 1'b1;
        end 
        if ( ENQUAD ) begin
            SO_IN_EN    = 1'b1;
            SI_IN_EN    = 1'b1;
            WP_IN_EN    = 1'b1;
            SIO3_IN_EN  = 1'b1;
        end
        if ( EN4XIO_Read_Mode == 1'b1 ) begin
            //$display( $time, " Enter READX4 Function ..." );
            Read_SHSL = 1'b1;
            STATE   <= `CMD_STATE;
            Read_4XIO_Mode = 1'b1; 
        end
        if ( ENDDR4XIO_Read_Mode == 1'b1 ) begin
            //$display( $time, " Enter DDR READX4 Function ..." );
            Read_SHSL = 1'b1;
            STATE   <= `CMD_STATE;
            DDRRead_4XIO_Mode = 1'b1;
            #1 DDR_Read_Mode_IN = 1'b1;
        end
        if ( HPM_RD == 1'b0 ) begin
            Read_SHSL <= #1 1'b0;   
        end
        #1;
        tDP_Chk = 1'b0;
    end

    always @ ( posedge tRES1_Chk ) begin : tRES1_Chk_Pro
        #tRES1;
        tRES1_Chk = 0;
    end

    always @ ( posedge tRES2_Chk ) begin : tRES2_Chk_Pro
        #tRES2;
        tRES2_Chk = 0;
    end

    always @ ( negedge SCLK or posedge CS_INT ) begin
        if ( CS_INT == 1'b0 && DDR_Read_Mode == 1'b1 ) begin
            #1 DDR_Read_Mode_IN = 1'b1;
        end
        else begin
            DDR_Read_Mode_IN = 1'b0;
        end  
    end

    always @ ( negedge SCLK or posedge CS_INT ) begin
        if ( CS_INT == 1'b0 && DDR_Read_Mode_IN == 1'b1 ) begin
            if ( SI_IN_EN == 1'b1 && SO_IN_EN == 1'b1 && WP_IN_EN == 1'b1 && SIO3_IN_EN == 1'b1 ) begin
                SI_Reg[31:0] = ( CR[5] || ADD_4B_Mode ) ? {SI_Reg[27:0], SIO3, WP, SO, SI} : {8'b0, SI_Reg[19:0], SIO3, WP, SO, SI};
            end 
            else  if ( SI_IN_EN == 1'b1 && SO_IN_EN == 1'b1 ) begin
                SI_Reg[31:0] = ( CR[5] || ADD_4B_Mode ) ? {SI_Reg[29:0], SO, SI} : {8'b0, SI_Reg[21:0], SO, SI};
            end
            else begin 
                SI_Reg[31:0] = ( CR[5] || ADD_4B_Mode ) ? {SI_Reg[30:0], SI} : {8'b0, SI_Reg[22:0], SI};
            end
            if ((( (ENDDR4XIO_Read_Mode == 1'b1 && Bit == 2 && !ENQUAD) ||
                   (ENDDR4XIO_Read_Mode == 1'b1 && Bit == 11 && ENQUAD) ||
                   (DDRRead_4XIO_Mode == 1'b1 && Bit == 10 && ENDDR4XIO_Read_Mode == 1'b0 && !ENQUAD) ||
                   (DDRRead_4XIO_Mode == 1'b1 && Bit == 19 && ENDDR4XIO_Read_Mode == 1'b0 && ENQUAD)) && !CR[5] && !ADD_4B_Mode) ||
                (( (ENDDR4XIO_Read_Mode == 1'b1 && Bit == 3 && !ENQUAD) ||
                   (ENDDR4XIO_Read_Mode == 1'b1 && Bit == 15 && ENQUAD) ||
                   (DDRRead_4XIO_Mode == 1'b1 && Bit == 11 && ENDDR4XIO_Read_Mode == 1'b0 && !ENQUAD) ||
                   (DDRRead_4XIO_Mode == 1'b1 && Bit == 23 && ENDDR4XIO_Read_Mode == 1'b0 && ENQUAD)) && (CR[5] || ADD_4B_Mode)) ) begin  
                Address = SI_Reg [A_MSB:0];
              if ( !CR[5] && !ADD_4B_Mode ) begin
                  Address [25:24] = EA_Reg[1:0];
              end
                load_address(Address);
            end  
        end
    end

    always @ ( posedge SCLK or posedge CS_INT ) begin
        if ( CS_INT == 1'b0 && DDR_Read_Mode_IN == 1'b1 && ENDDR4XIO_Read_Mode == 1'b1 ) begin
            if ( SI_IN_EN == 1'b1 && SO_IN_EN == 1'b1 && WP_IN_EN == 1'b1 && SIO3_IN_EN == 1'b1 ) begin
                SI_Reg_DDR[31:0] = ( CR[5] || ADD_4B_Mode ) ? {SI_Reg_DDR[27:0], SIO3, WP, SO, SI} : {8'b0, SI_Reg_DDR[19:0], SIO3, WP, SO, SI};
            end
        end
        else begin
                SI_Reg_DDR[31:0] = 32'h0000_0000;
        end
    end

    always @ ( posedge SCLK or posedge CS_INT ) begin
        #0;  
        if ( CS_INT == 1'b0 ) begin
            if ( ENQUAD ) begin
                Bit_Tmp = Bit_Tmp + 4;
                Bit     = Bit_Tmp - 1;
            end
            else begin
                Bit_Tmp = Bit_Tmp + 1;
                Bit     = Bit_Tmp - 1;
            end
            if ( SI_IN_EN == 1'b1 && SO_IN_EN == 1'b1 && WP_IN_EN == 1'b1 && SIO3_IN_EN == 1'b1 ) begin
                SI_Reg[31:0] = ( CR[5] || ADD_4B_Mode ) ? {SI_Reg[27:0], SIO3, WP, SO, SI} : {8'b0, SI_Reg[19:0], SIO3, WP, SO, SI};
            end 
            else  if ( SI_IN_EN == 1'b1 && SO_IN_EN == 1'b1 ) begin
                SI_Reg[31:0] = ( CR[5] || ADD_4B_Mode ) ? {SI_Reg[29:0], SO, SI} : {8'b0, SI_Reg[21:0], SO, SI};
            end
            else if ( SI_IN_EN == 1'b1 ) begin 
                SI_Reg[31:0] = ( CR[5] || ADD_4B_Mode ) ? {SI_Reg[30:0], SI} : {8'b0, SI_Reg[22:0], SI};
            end

            if ( (EN4XIO_Read_Mode == 1'b1 && ((Bit == 5 && !ENQUAD && !CR[5] && !ADD_4B_Mode ) || (Bit == 23 && ENQUAD && !CR[5] && !ADD_4B_Mode ))) ) begin
                Address = SI_Reg[A_MSB:0];
                Address[25:24] = EA_Reg[1:0];
                load_address(Address);
            end
            else if ( (EN4XIO_Read_Mode == 1'b1 && ((Bit == 7 && !ENQUAD && ( CR[5] || ADD_4B_Mode )) || (Bit == 31 && ENQUAD && ( CR[5] || ADD_4B_Mode )))) ) begin
                Address = SI_Reg[A_MSB:0];
                load_address(Address);
            end  
        end     
  
        if ( Bit == 7 && CS_INT == 1'b0 && ~HPM_RD && ( !EN_Boot || FBE ) ) begin
            STATE = `CMD_STATE;
            CMD_BUS = SI_Reg[7:0];
            //$display( $time,"SI_Reg[7:0]= %h ", SI_Reg[7:0] );
            if ( During_RST_REC )
                $display ($time," During reset recovery time, there is command. \n");
        end

        if ( CS_INT == 1'b0 && ~HPM_RD && ( EN_Boot && !FBE ) ) begin
            STATE = `FAST_BOOT_STATE;
            if ( During_RST_REC )
                $display ($time," During reset recovery time, there is command. \n");
        end

        if ( (EN4XIO_Read_Mode && (Bit == 1 || (ENQUAD && Bit==7))) && CS_INT == 1'b0
             && HPM_RD && (SI_Reg[7:0]== RSTEN || SI_Reg[7:0]== RST)) begin
            CMD_BUS = SI_Reg[7:0];
            //$display( $time,"SI_Reg[7:0]= %h ", SI_Reg[7:0] );
        end

        if ( (ENDDR4XIO_Read_Mode && (Bit == 1 || (ENQUAD && Bit==7))) && CS_INT == 1'b0
             && HPM_RD && (SI_Reg_DDR[7:0]== RSTEN || SI_Reg_DDR[7:0]== RST)) begin
            CMD_BUS = SI_Reg_DDR[7:0];
            //$display( $time,"SI_Reg[7:0]= %h ", SI_Reg[7:0] );
        end

        
        case ( STATE )
            `STANDBY_STATE: 
                begin
                end

            `FAST_BOOT_STATE:
                begin
                    Read_SHSL = 1'b1;
                    FAST_BOOT_Mode = 1'b1;
                end

            `CMD_STATE: 
                begin
                    case ( CMD_BUS ) 
                    WREN: 
                        begin
                            if ( !DP_Mode && !WIP && Chip_EN && ~HPM_RD ) begin
                                if ( CS_INT == 1'b1 && Bit == 7 ) begin 
                                    // $display( $time, " Enter Write Enable Function ..." );
                                    write_enable;
                                end
                                else if ( Bit > 7 )
                                    STATE <= `BAD_CMD_STATE; 
                            end 
                            else if ( Bit == 7 )
                                STATE <= `BAD_CMD_STATE; 
                        end
                     
                    WRDI:   
                        begin
                            if ( !DP_Mode && Chip_EN && ~HPM_RD ) begin
                                if ( CS_INT == 1'b1 && Bit == 7 ) begin 
                                    // $display( $time, " Enter Write Disable Function ..." );
                                    write_disable;
                                end
                                else if ( Bit > 7 )
                                    STATE <= `BAD_CMD_STATE; 
                            end 
                            else if ( Bit == 7 )
                                STATE <= `BAD_CMD_STATE; 
                        end 

                    RDID:
                        begin
                            if ( !DP_Mode && !WIP && Chip_EN && ~HPM_RD && !ENQUAD ) begin
                                //$display( $time, " Enter Read ID Function ..." );
                                 Read_SHSL = 1'b1;
                                 RDID_Mode = 1'b1;
                             end
                            else if ( Bit == 7 )
                                STATE <= `BAD_CMD_STATE;
                          end

                    EN4B:
                        begin
                            if ( !DP_Mode && !WIP && Chip_EN && !EPSUSP ) begin
                                if ( CS_INT == 1'b1 && Bit == 7 ) begin
                                    // $display( $time, " Enter 4-byte mode ..." );
                                    CR[5] <= 1'b1;
                                    EN4B_Mode <= 1'b1;
                                end
                                else if ( Bit > 7 )
                                    STATE <= `BAD_CMD_STATE;
                            end
                            else if ( Bit == 7 )
                                STATE <= `BAD_CMD_STATE;
                        end

                    EX4B:
                        begin
                            if ( !DP_Mode && !WIP && Chip_EN && !EPSUSP ) begin
                                if ( CS_INT == 1'b1 && Bit == 7 ) begin
                                    // $display( $time, " Exit 4-byte mode ..." );
                                    CR[5] <= 1'b0;
                                    EN4B_Mode <= 1'b0;
                                end
                                else if ( Bit > 7 )
                                    STATE <= `BAD_CMD_STATE;
                            end
                            else if ( Bit == 7 )
                                STATE <= `BAD_CMD_STATE;
                        end

                    QPIID:
                        begin
                            if ( !DP_Mode && !WIP && Chip_EN && ~HPM_RD && ENQUAD ) begin
                                //$display( $time, " Enter Read ID Function ..." );
                                Read_SHSL = 1'b1;
                                RDID_Mode = 1'b1;
                            end
                            else if ( Bit == 7 )
                                STATE <= `BAD_CMD_STATE;
                        end

                    RDSR:
                        begin 
                            if ( !DP_Mode && Chip_EN && ~HPM_RD) begin 
                                //$display( $time, " Enter Read Status Function ..." );
                                Read_SHSL = 1'b1;
                                RDSR_Mode = 1'b1 ;
                            end
                            else if ( Bit == 7 )
                                STATE <= `BAD_CMD_STATE;        
                        end

                    RDCR:
                        begin
                            if ( !DP_Mode && Chip_EN && ~HPM_RD) begin
                                //$display( $time, " Enter Read Configuration Status Function ..." );
                                Read_SHSL = 1'b1;
                                RDCR_Mode = 1'b1 ;
                            end
                            else if ( Bit == 7 )
                                STATE <= `BAD_CMD_STATE;
                        end

           
                    WRSR:
                        begin
                            if ( !DP_Mode && !WIP && WEL && Chip_EN && !Secur_Mode && ~HPM_RD && !EPSUSP ) begin
                                if ( CS_INT == 1'b1 && Bit == 15 || CS_INT == 1'b1 && Bit == 23 ) begin
                                    if ( Dis_WRSR ) begin 
                                        Status_Reg[1] = 1'b0;
                                        Secur_Reg[5]  = 1'b1;
                                    end
                                    else if (CS_INT == 1'b1 && Bit == 15) begin 
                                        //$display( $time, " Enter Write Status Function ..." ); 
                                        ->WRSR_Event;
                                        WRSR_Mode = 1'b1;
                                    end 
                                    else if (CS_INT == 1'b1 && Bit == 23) begin                  
                                        //$display( $time, " Enter Write Status Function ..." ); 
                                        ->WRSR_Event;
                                        WRSR2_Mode = 1'b1;
                                    end
                 
                                end    
                                else if ( CS_INT == 1'b1 && (Bit < 15 || Bit > 15 && Bit < 23) )
                                    STATE <= `BAD_CMD_STATE;
                                else if ( (CS_INT == 1'b1 &&  Bit > 23) )

                                    STATE <= `BAD_CMD_STATE;
                            end
                            else if ( Bit == 7 )
                                STATE <= `BAD_CMD_STATE;
                        end 
                      
                    SBL:
                        begin
                            if ( !DP_Mode && !WIP && Chip_EN && ~HPM_RD ) begin  // no WEL
                                if ( CS_INT == 1'b1 && Bit == 15 ) begin
                                    //$display( $time, " Enter Set Burst Length Function ..." );
                                    EN_Burst = !SI_Reg[4];
                                    if ( SI_Reg[7:5]==3'b000 && SI_Reg[3:2]==2'b00 ) begin
                                        if ( SI_Reg[1:0]==2'b00 )
                                            Burst_Length = 8;
                                        else if ( SI_Reg[1:0]==2'b01 )
                                            Burst_Length = 16;
                                        else if ( SI_Reg[1:0]==2'b10 )
                                            Burst_Length = 32;
                                        else if ( SI_Reg[1:0]==2'b11 )
                                            Burst_Length = 64;
                                    end
                                    else begin
                                        Burst_Length = 8;
                                    end
                                end
                                else if ( CS_INT == 1'b1 && Bit < 15 || Bit > 15 )
                                    STATE <= `BAD_CMD_STATE;
                            end
                            else if ( Bit == 7 )
                                STATE <= `BAD_CMD_STATE;
                        end

                    READ1X: 
                        begin
                            if ( !DP_Mode && !WIP && Chip_EN && ~HPM_RD && !ENQUAD ) begin
                                //$display( $time, " Enter Read Data Function ..." );
                                Read_SHSL = 1'b1;
                                if ( (Bit == 31 && !CR[5]) || (Bit == 39 && CR[5]) ) begin
                                    Address = SI_Reg [A_MSB:0];
                                    if ( !CR[5] ) begin
                                            Address [25:24] = EA_Reg[1:0];
                                    end
                                    load_address(Address);
                                end
                                Read_1XIO_Mode = 1'b1;
                            end 
                            else if ( Bit == 7 )
                                STATE <= `BAD_CMD_STATE;                                
                        end

                    READ4B: 
                        begin
                            if ( !DP_Mode && !WIP && Chip_EN && ~HPM_RD && !ENQUAD ) begin
                                //$display( $time, " Enter Read Data Function ..." );
                                Read_SHSL = 1'b1;
                                if ( Bit == 39  ) begin
                                    Address = SI_Reg [A_MSB:0];
                                    load_address(Address);
                                end
                                Read_1XIO_Mode = 1'b1;
                                ADD_4B_Mode = 1'b1;
                            end 
                            else if ( Bit == 7 )
                                STATE <= `BAD_CMD_STATE;                                
                        end

                    FASTREAD1X:
                        begin
                            if ( !DP_Mode && !WIP && Chip_EN && ~HPM_RD && !ENQUAD ) begin
                                //$display( $time, " Enter Fast Read Data Function ..." );
                                Read_SHSL = 1'b1;
                                if ( (Bit == 31 && !CR[5]) || (Bit == 39 && CR[5]) ) begin
                                    Address = SI_Reg [A_MSB:0];
                                    if ( !CR[5] ) begin
                                            Address [25:24] = EA_Reg[1:0];
                                    end
                                    load_address(Address);
                                end
                                FastRD_1XIO_Mode = 1'b1;
                            end 
                            else if ( Bit == 7 )
                                STATE <= `BAD_CMD_STATE;                                
                        end

                    FASTREAD4B:
                        begin
                            if ( !DP_Mode && !WIP && Chip_EN && ~HPM_RD && !ENQUAD ) begin
                                //$display( $time, " Enter Fast Read Data Function ..." );
                                Read_SHSL = 1'b1;
                                if ( Bit == 39 ) begin
                                    Address = SI_Reg [A_MSB:0];
                                    load_address(Address);
                                end
                                FastRD_1XIO_Mode = 1'b1;
                                ADD_4B_Mode = 1'b1;
                            end 
                            else if ( Bit == 7 )
                                STATE <= `BAD_CMD_STATE;                                
                        end

                    SE: 
                        begin
                            if ( !DP_Mode && !WIP && WEL && !Secur_Mode &&  Chip_EN && ~HPM_RD && !EPSUSP ) begin
                                if ( (Bit == 31 && !CR[5]) || (Bit == 39 && CR[5]) ) begin
                                    Address = SI_Reg [A_MSB:0];
                                    if ( !CR[5] ) begin
                                            Address [25:24] = EA_Reg[1:0];
                                    end
                                end
                                if ( CS_INT == 1'b1 && ((Bit == 31 && !CR[5]) || (Bit == 39 && CR[5])) ) begin
                                    //$display( $time, " Enter Sector Erase Function ..." );
                                    ->SE_4K_Event;
                                    SE_4K_Mode = 1'b1;
                                end
                                else if ( CS_INT == 1'b1 && ((Bit != 31 && !CR[5]) || (Bit != 39 && CR[5])) )
                                     STATE <= `BAD_CMD_STATE;
                            end
                            else if ( Bit == 7 )
                                STATE <= `BAD_CMD_STATE;
                        end

                    SE4B: 
                        begin
                            if ( !DP_Mode && !WIP && WEL && !Secur_Mode &&  Chip_EN && ~HPM_RD && !EPSUSP ) begin
                                ADD_4B_Mode = 1'b1;
                                if ( Bit == 39 ) begin
                                    Address = SI_Reg [A_MSB:0];
                                end
                                if ( CS_INT == 1'b1 && Bit == 39 ) begin
                                    //$display( $time, " Enter Sector Erase Function ..." );
                                    ->SE_4K_Event;
                                    SE_4K_Mode = 1'b1;
                                end
                                else if ( CS_INT == 1'b1 && Bit != 39 )
                                     STATE <= `BAD_CMD_STATE;
                            end
                            else if ( Bit == 7 )
                                STATE <= `BAD_CMD_STATE;
                        end

                    BE: 
                        begin
                            if ( !DP_Mode && !WIP && WEL && !Secur_Mode &&  Chip_EN && ~HPM_RD && !EPSUSP ) begin
                                if ( (Bit == 31 && !CR[5]) || (Bit == 39 && CR[5]) ) begin
                                    Address = SI_Reg [A_MSB:0];
                                    if ( !CR[5] ) begin
                                            Address [25:24] = EA_Reg[1:0];
                                    end
                                end
                                if ( CS_INT == 1'b1 && ((Bit == 31 && !CR[5]) || (Bit == 39 && CR[5])) ) begin
                                    //$display( $time, " Enter Block Erase Function ..." );
                                    ->BE_Event;
                                    BE_Mode = 1'b1;
                                    BE64K_Mode = 1'b1;
                                end
                                else if ( CS_INT == 1'b1 && ((Bit != 31 && !CR[5]) || (Bit != 39 && CR[5])) ) 
                                    STATE <= `BAD_CMD_STATE;
                            end 
                            else if ( Bit == 7 )
                                STATE <= `BAD_CMD_STATE;
                        end

                    BE4B: 
                        begin
                            if ( !DP_Mode && !WIP && WEL && !Secur_Mode &&  Chip_EN && ~HPM_RD && !EPSUSP ) begin
                                ADD_4B_Mode = 1'b1;
                                if ( Bit == 39 ) begin
                                    Address = SI_Reg [A_MSB:0];
                                end
                                if ( CS_INT == 1'b1 && Bit == 39 ) begin
                                    //$display( $time, " Enter Block Erase Function ..." );
                                    ->BE_Event;
                                    BE_Mode = 1'b1;
                                    BE64K_Mode = 1'b1;
                                end 
                                else if ( CS_INT == 1'b1 && Bit != 39 )
                                    STATE <= `BAD_CMD_STATE;
                            end 
                            else if ( Bit == 7 )
                                STATE <= `BAD_CMD_STATE;
                        end

                    BE32K:
                        begin
                            if ( !DP_Mode && !WIP && WEL && !Secur_Mode && Chip_EN && ~HPM_RD && !EPSUSP ) begin
                                if ( (Bit == 31 && !CR[5]) || (Bit == 39 && CR[5]) ) begin
                                    Address = SI_Reg [A_MSB:0];
                                    if ( !CR[5] ) begin
                                            Address [25:24] = EA_Reg[1:0];
                                    end
                                end
                                if ( CS_INT == 1'b1 && ((Bit == 31 && !CR[5]) || (Bit == 39 && CR[5])) ) begin
                                    //$display( $time, " Enter Block 32K Erase Function ..." );
                                    ->BE32K_Event;
                                    BE_Mode = 1'b1;
                                    BE32K_Mode = 1'b1;
                                end
                                else if ( CS_INT == 1'b1 && ((Bit != 31 && !CR[5]) || (Bit != 39 && CR[5])) )
                                    STATE <= `BAD_CMD_STATE;
                            end
                            else if ( Bit == 7 )
                                STATE <= `BAD_CMD_STATE;
                        end

                    BE32K4B:
                        begin
                            if ( !DP_Mode && !WIP && WEL && !Secur_Mode && Chip_EN && ~HPM_RD && !EPSUSP ) begin
                                ADD_4B_Mode = 1'b1;
                                if ( Bit == 39 ) begin
                                    Address = SI_Reg [A_MSB:0];
                                end
                                if ( CS_INT == 1'b1 && Bit == 39  ) begin
                                    //$display( $time, " Enter Block 32K Erase Function ..." );
                                    ->BE32K_Event;
                                    BE_Mode = 1'b1;
                                    BE32K_Mode = 1'b1;
                                end
                                else if ( CS_INT == 1'b1 && Bit != 39 )
                                    STATE <= `BAD_CMD_STATE;
                            end
                            else if ( Bit == 7 )
                                STATE <= `BAD_CMD_STATE;
                        end

                    SUSP, SUSP1:
                        begin
                            if ( !DP_Mode && WEL && !Secur_Mode &&  Chip_EN && ~HPM_RD && !EPSUSP ) begin
                                if ( CS_INT == 1'b1 && Bit == 7 ) begin
                                    //$display( $time, " Enter Suspend Function ..." );
                                    ->Susp_Event;
                                end
                                else if ( Bit > 7 )
                                    STATE <= `BAD_CMD_STATE;
                            end
                            else if ( Bit == 7 )
                                STATE <= `BAD_CMD_STATE;
                        end

                    RESU, RESU1:
                        begin
                            if ( !DP_Mode && !WIP && Chip_EN && ~HPM_RD && EPSUSP ) begin
                                if ( CS_INT == 1'b1 && Bit == 7 ) begin
                                    //$display( $time, " Enter Resume Function ..." );
                                    Secur_Mode = 1'b0;
                                    ->Resume_Event;
                                end
                                else if ( Bit > 7 )
                                    STATE <= `BAD_CMD_STATE;
                            end
                            else if ( Bit == 7 )
                                STATE <= `BAD_CMD_STATE;
                        end
                      
                    CE1, CE2:
                        begin
                            if ( !DP_Mode && !WIP && WEL && !Secur_Mode && Chip_EN && ~HPM_RD && !EPSUSP) begin
                                if ( CS_INT == 1'b1 && Bit == 7 ) begin
                                    //$display( $time, " Enter Chip Erase Function ..." );
                                    ->CE_Event;
                                    CE_Mode = 1'b1 ;
                                end 
                                else if ( Bit > 7 )
                                    STATE <= `BAD_CMD_STATE;
                            end
                            else if ( Bit == 7 ) 
                                STATE <= `BAD_CMD_STATE;
                        end
                      
                    PP: 
                        begin
                            if ( !DP_Mode && !WIP && WEL && Chip_EN && ~HPM_RD && !EPSUSP) begin
                                if ( (Bit == 31 && !CR[5]) || (Bit == 39 && CR[5]) ) begin
                                    Address = SI_Reg [A_MSB:0];
                                    if ( !CR[5] ) begin
                                            Address [25:24] = EA_Reg[1:0];
                                    end
                                    load_address(Address);
                                end

                                if ( (Bit == 31 && !CR[5]) || (Bit == 39 && CR[5]) ) begin
                                    //$display( $time, " Enter Page Program Function ..." );
                                    if ( CS_INT == 1'b0 ) begin
                                        ->PP_Event;
                                        PP_1XIO_Mode = 1'b1;
                                    end  
                                end
                                else if ( CS_INT == 1 &&( ( ((Bit < 39) || ((Bit + 1) % 8 !== 0))) ) && !CR[5] ) begin
                                    STATE <= `BAD_CMD_STATE;
                                end
                                else if ( CS_INT == 1 &&( ( ((Bit < 47) || ((Bit + 1) % 8 !== 0))) ) && CR[5] ) begin
                                    STATE <= `BAD_CMD_STATE;
                                end
                            end
                            else if ( Bit == 7 )
                                STATE <= `BAD_CMD_STATE;
                        end

                    PP4B: 
                        begin
                            if ( !DP_Mode && !WIP && WEL && Chip_EN && ~HPM_RD && !EPSUSP) begin
                                ADD_4B_Mode = 1'b1;
                                if ( Bit == 39 ) begin
                                    Address = SI_Reg [A_MSB:0];
                                    load_address(Address);
                                end

                                if ( Bit == 39 ) begin
                                    //$display( $time, " Enter Page Program Function ..." );
                                    if ( CS_INT == 1'b0 ) begin
                                        ->PP_Event;
                                        PP_1XIO_Mode = 1'b1;
                                    end  
                                end
                                else if ( CS_INT == 1 &&( ( ((Bit < 47) || ((Bit + 1) % 8 !== 0))) ) ) begin
                                    STATE <= `BAD_CMD_STATE;
                                end
                            end
                            else if ( Bit == 7 )
                                STATE <= `BAD_CMD_STATE;
                        end

                    SFDP_READ:
                        begin
                            if ( !DP_Mode && !Secur_Mode && !WIP && Chip_EN && ~HPM_RD ) begin
                                //$display( $time, " Enter SFDP read mode ..." );
                                if ( Bit == 31 ) begin
                                    Address = SI_Reg [A_MSB:0];
                                    load_address(Address);
                                end
                                if ( Bit == 7 ) begin
                                    SFDP_Mode = 1;
                                    if (ENQUAD) begin
                                        Read_4XIO_Mode = 1'b1;
                                    end
                                    else begin
                                        FastRD_1XIO_Mode = 1'b1;
                                    end
                                    Read_SHSL = 1'b1;
                                end
                            end
                            else if ( Bit == 7 )
                                STATE <= `BAD_CMD_STATE;
                        end

                    RDFBR:
                        begin 
                            if ( !DP_Mode && !WIP && Chip_EN && ~HPM_RD && !ENQUAD ) begin 
                                //$display( $time, " Enter Read Fast Boot Register Function ..." );
                                Read_SHSL = 1'b1;
                                RDFBR_Mode = 1'b1 ;
                            end
                            else if ( Bit == 7 )
                                STATE <= `BAD_CMD_STATE;        
                        end

                    WRFBR:
                        begin
                            if ( !DP_Mode && !WIP && WEL && Chip_EN && !Secur_Mode && ~HPM_RD && !EPSUSP && !ENQUAD ) begin
                                if ( CS_INT == 1'b0 && Bit == 7 ) begin
                                    //$display( $time, " Enter Write Fast Boot Register Function ..." ); 
                                    ->WRFBR_Event;
                                    WRFBR_Mode = 1'b1;
                                end    
                                else if ( CS_INT == 1'b1 && (Bit < 39 || Bit > 39) )
                                    STATE <= `BAD_CMD_STATE;
                            end
                            else if ( Bit == 7 )
                                STATE <= `BAD_CMD_STATE;
                        end

                    ESFBR:
                        begin
                            if ( !DP_Mode && !WIP && WEL && Chip_EN && !Secur_Mode && ~HPM_RD && !EPSUSP && !ENQUAD ) begin
                                if ( CS_INT == 1'b1 && Bit == 7 ) begin
                                    //$display( $time, " Enter Erase Fast Boot Register Function ..." );
                                    ->ESFBR_Event;
                                    ESFBR_Mode = 1'b1;
                                end
                                else if ( Bit > 7 )
                                    STATE <= `BAD_CMD_STATE;
                            end
                            else if ( Bit == 7 )
                                STATE <= `BAD_CMD_STATE;
                        end

                    WPSEL:
                        begin
                            if ( !DP_Mode && !WIP && WEL && Norm_Array_Mode && Chip_EN && ~HPM_RD && !EPSUSP && !ENQUAD ) begin
                                if ( CS_INT == 1'b1 && Bit == 7 ) begin
                                    //$display( $time, " Enter Write Protection Selection Function ..." );
                                    ->WPSEL_Event;
                                end
                                else if ( Bit > 7 )
                                    STATE <= `BAD_CMD_STATE;
                            end
                            else if ( Bit == 7 )
                                STATE <= `BAD_CMD_STATE;
                        end

                    WRLR:
                        begin
                            if ( !DP_Mode && !WIP && WEL && Norm_Array_Mode && WPSEL_Mode && Chip_EN && ~HPM_RD && !EPSUSP && !ENQUAD ) begin
                                if ( CS_INT == 1'b1 && Bit == 23 ) begin
                                    //$display( $time, " Enter Write Lock Register Function ..." ); 
                                    ->WRLR_Event;
                                    WRLR_Mode = 1'b1;
                                end    
                                else if ( CS_INT == 1'b1 && (Bit < 23 || Bit > 23) )
                                    STATE <= `BAD_CMD_STATE;
                            end
                            else if ( Bit == 7 )
                                STATE <= `BAD_CMD_STATE;
                        end

                    RDLR:
                        begin 
                            if ( !DP_Mode && !WIP && Norm_Array_Mode && WPSEL_Mode && Chip_EN && ~HPM_RD && !ENQUAD ) begin 
                                //$display( $time, " Enter Read Lock Register Function ..." );
                                Read_SHSL = 1'b1;
                                RDLR_Mode = 1'b1 ;
                            end
                            else if ( Bit == 7 )
                                STATE <= `BAD_CMD_STATE;        
                        end

`ifdef Type_00
                    WRPASS:
                        begin
                            if ( !DP_Mode && !WIP && WEL && Norm_Array_Mode && WPSEL_Mode && Chip_EN && ~HPM_RD && !EPSUSP && !ENQUAD && PWDMLB ) begin
                                if ( CS_INT == 1'b0 && Bit == 7 ) begin
                                    //$display( $time, " Enter Write Lock Register Function ..." ); 
                                    ->WRPASS_Event;
                                    WRPASS_Mode = 1'b1;
                                end    
                                else if (Bit == 39) begin
                                    Address = SI_Reg [A_MSB:0];
                                end
                                else if ( CS_INT == 1'b1 && (Bit < 103 || Bit > 103) )
                                    STATE <= `BAD_CMD_STATE;
                            end
                            else if ( Bit == 7 )
                                STATE <= `BAD_CMD_STATE;
                        end

                    PASSULK:
                        begin
                            if ( !DP_Mode && !WIP && WEL && Norm_Array_Mode && WPSEL_Mode && Chip_EN && ~HPM_RD && !EPSUSP && !ENQUAD && !PWDMLB ) begin
                                if ( CS_INT == 1'b0 && Bit == 7 ) begin
                                    //$display( $time, " Enter Write Lock Register Function ..." ); 
                                    ->PASSULK_Event;
                                    PASSULK_Mode = 1'b1;
                                end    
                                else if (Bit == 39) begin
                                    Address = SI_Reg [A_MSB:0];
                                end
                                   else if ( CS_INT == 1'b1 && (Bit < 103 || Bit > 103) )
                                    STATE <= `BAD_CMD_STATE;
                            end
                            else if ( Bit == 7 )
                                STATE <= `BAD_CMD_STATE;
                        end

                    RDPASS:
                        begin
                            if ( !DP_Mode && !WIP && Norm_Array_Mode && WPSEL_Mode && Chip_EN && ~HPM_RD && !ENQUAD && PWDMLB ) begin
                                //$display( $time, " Enter Read Password Register Function ..." );
                                Read_SHSL = 1'b1;
                                if (Bit == 39) begin
                                    Address = SI_Reg [A_MSB:0];
                                end
                                RDPASS_Mode = 1'b1;
                            end
                            else if ( Bit == 7 )
                                STATE <= `BAD_CMD_STATE;
                        end
`endif

                    WRSPB:
                        begin
                            if ( !DP_Mode && !WIP && WEL && Norm_Array_Mode && WPSEL_Mode && Chip_EN && ~HPM_RD && !EPSUSP && !ENQUAD ) begin
                                ADD_4B_Mode = 1'b1;
                                if ( Bit == 39 ) begin
                                    Address = SI_Reg[A_MSB:0] ;
                                end
                                if ( CS_INT == 1'b1 && Bit == 39 ) begin
                                    //$display( $time, " Enter Write SPB Function ..." );
                                    ->WRSPB_Event;
                                    WRSPB_Mode = 1'b1;
                                end
                                else if ( CS_INT == 1'b1 && Bit < 39 || Bit > 39 )
                                    STATE <= `BAD_CMD_STATE;
                            end
                           else if ( Bit == 7 )
                                STATE <= `BAD_CMD_STATE;
                        end

                    RDSPB:
                        begin
                            if ( !DP_Mode && !WIP && Norm_Array_Mode && WPSEL_Mode && Chip_EN && ~HPM_RD && !ENQUAD ) begin
                                ADD_4B_Mode = 1'b1;
                                if ( Bit == 39 ) begin
                                    Address = SI_Reg[A_MSB:0] ;
                                end
                                //$display( $time, " Enter Read SPB Register Function ..." );
                                if ( Bit == 7 ) begin
                                    Read_SHSL = 1'b1;
                                    RDSPB_Mode = 1'b1 ;
                                end
                            end
                            else if ( Bit == 7 )
                                STATE <= `BAD_CMD_STATE;
                        end

                    ESSPB:
                        begin
                            if ( !DP_Mode && !WIP && WEL && Norm_Array_Mode && WPSEL_Mode && Chip_EN && ~HPM_RD && !EPSUSP && !ENQUAD ) begin
                                if ( CS_INT == 1'b1 && Bit == 7 ) begin
                                    //$display( $time, " Enter Erase SPB Function ..." );
                                    ->ESSPB_Event;
                                    ESSPB_Mode = 1'b1;
                                end
                                else if ( Bit > 7 )
                                    STATE <= `BAD_CMD_STATE;
                            end
                           else if ( Bit == 7 )
                                STATE <= `BAD_CMD_STATE;
                        end

                    WRDPB:
                        begin
                            if ( !DP_Mode && !WIP && WEL && Norm_Array_Mode && WPSEL_Mode && Chip_EN && ~HPM_RD && !EPSUSP && !ENQUAD ) begin
                                ADD_4B_Mode = 1'b1;
                                if ( Bit == 39 ) begin
                                    Address = SI_Reg[A_MSB:0] ;
                                end
                                if ( CS_INT == 1'b1 && Bit == 47 ) begin
                                    //$display( $time, " Enter Write DPB Function ..." );
                                    ->WRDPB_Event;
                                    WRDPB_Mode = 1'b1;
                                end
                                else if ( CS_INT == 1'b1 && Bit < 47 || Bit > 47 )
                                    STATE <= `BAD_CMD_STATE;
                            end
                           else if ( Bit == 7 )
                                STATE <= `BAD_CMD_STATE;
                        end

                    RDDPB:
                        begin
                            if ( !DP_Mode && !WIP && Norm_Array_Mode && WPSEL_Mode && Chip_EN && ~HPM_RD && !ENQUAD ) begin
                                ADD_4B_Mode = 1'b1;
                                if ( Bit == 39 ) begin
                                    Address = SI_Reg[A_MSB:0] ;
                                end
                                //$display( $time, " Enter Read DPB Register Function ..." );
                                if ( Bit == 7 ) begin
                                    Read_SHSL = 1'b1;
                                    RDDPB_Mode = 1'b1 ;
                                end
                            end
                            else if ( Bit == 7 )
                                STATE <= `BAD_CMD_STATE;
                        end

                    GBLK:
                        begin
                            if ( !DP_Mode && !WIP && WEL && Norm_Array_Mode && WPSEL_Mode && Chip_EN && !EPSUSP && !ENQUAD ) begin
                                if ( CS_INT == 1'b1 && Bit == 7 ) begin
                                    //$display( $time, " Enter Chip Protection Function ..." );
                                    ->GBLK_Event;
                                end
                                else if ( CS_INT == 1'b1 && Bit > 7 )
                                    STATE <= `BAD_CMD_STATE;
                            end
                            else if ( Bit == 7 )
                                STATE <= `BAD_CMD_STATE;
                        end

                    GBULK:
                        begin
                            if ( !DP_Mode && !WIP && WEL && Norm_Array_Mode && WPSEL_Mode && Chip_EN && !EPSUSP && !ENQUAD ) begin
                                if ( CS_INT == 1'b1 && Bit == 7 ) begin
                                    //$display( $time, " Enter Chip Unprotection Function ..." );
                                    ->GBULK_Event;
                                end
                                else if ( CS_INT == 1'b1 && Bit > 7 )
                                    STATE <= `BAD_CMD_STATE;
                            end
                            else if ( Bit == 7 )
                                STATE <= `BAD_CMD_STATE;
                        end

                    DP:
                        begin
                            if ( !WIP && Chip_EN && ~HPM_RD && !EPSUSP ) begin
                                if ( CS_INT == 1'b1 && Bit == 7 && DP_Mode == 1'b0 ) begin
                                    //$display( $time, " Enter Deep Power Down Function ..." );
                                    tDP_Chk = 1'b1;
                                    DP_Mode = 1'b1;
                                end
                                else if ( Bit > 7 )
                                    STATE <= `BAD_CMD_STATE;
                            end
                            else if ( Bit == 7 )
                                STATE <= `BAD_CMD_STATE;
                        end

                    RDP, RES:
                        begin
                            if ( ( !WIP || During_Susp_Wait) && Chip_EN && ~HPM_RD ) begin
                                // $display( $time, " Enter Release from Deep Power Down Function ..." );
                                RES_Mode = 1'b1;
                                Read_SHSL = 1'b1;
                                if ( CS_INT == 1'b1 && SCLK == 1'b0 && tRES1_Chk &&
                                   ((Bit >= 38 && !ENQUAD) || (Bit >=38 && ENQUAD)) ) begin
                                    tRES1_Chk = 1'b0;
                                    tRES2_Chk = 1'b1;
                                    DP_Mode = 1'b0;
                                end
                                else if ( CS_INT == 1'b1 && SCLK == 1'b1 && tRES1_Chk &&
                                        ((Bit >= 39 && !ENQUAD) || (Bit >=39 && ENQUAD)) ) begin
                                    tRES1_Chk = 1'b0;
                                    tRES2_Chk = 1'b1;
                                    DP_Mode = 1'b0;
                                end
                                else if ( CS_INT == 1'b1 && Bit > 0 && DP_Mode ) begin
                                    tRES1_Chk = 1'b1;
                                    DP_Mode = 1'b0;
                                end
                            end
                            else if ( Bit == 7 )
                                STATE <= `BAD_CMD_STATE;
                        end

                    REMS:
                        begin
                            if ( !DP_Mode && (!WIP || During_Susp_Wait) && Chip_EN && ~HPM_RD && !ENQUAD ) begin
                                if ( Bit == 31 ) begin
                                    Address = SI_Reg[A_MSB:0] ;
                                end
                                //$display( $time, " Enter Read Electronic Manufacturer & ID Function ..." );
                                Read_SHSL = 1'b1;
                                REMS_Mode = 1'b1;
                            end
                            else if ( Bit == 7 )
                                STATE <= `BAD_CMD_STATE;                            
                        end

                    READ2X: 
                        begin 
                            if ( !DP_Mode && !WIP && Chip_EN && ~HPM_RD && !ENQUAD ) begin
                                //$display( $time, " Enter READX2 Function ..." );
                                Read_SHSL = 1'b1;
                                if ( (Bit == 19 && !CR[5]) || (Bit == 23 && CR[5]) ) begin
                                    Address = SI_Reg [A_MSB:0];
                                    if ( !CR[5] ) begin
                                            Address [25:24] = EA_Reg[1:0];
                                    end
                                    load_address(Address);
                                end
                                Read_2XIO_Mode = 1'b1;
                            end 
                            else if ( Bit == 7 )
                                STATE <= `BAD_CMD_STATE;                                
                        end

                    READ2X4B: 
                        begin 
                            if ( !DP_Mode && !WIP && Chip_EN && ~HPM_RD && !ENQUAD ) begin
                                //$display( $time, " Enter READX2 Function ..." );
                                Read_SHSL = 1'b1;
                                if ( Bit == 23 ) begin
                                    Address = SI_Reg [A_MSB:0];
                                    load_address(Address);
                                end
                                Read_2XIO_Mode = 1'b1;
                                ADD_4B_Mode = 1'b1;
                            end 
                            else if ( Bit == 7 )
                                STATE <= `BAD_CMD_STATE;                                
                        end

                    ENSO: 
                        begin
                            if ( !DP_Mode && !WIP && Chip_EN && ~HPM_RD ) begin
                                if ( CS_INT == 1'b1 && Bit == 7 ) begin  
                                    //$display( $time, " Enter ENSO  Function ..." );
                                    enter_secured_otp;
                                end
                                else if ( Bit > 7 )
                                    STATE <= `BAD_CMD_STATE;
                            end
                            else if ( Bit == 7 )
                                STATE <= `BAD_CMD_STATE;
                        end
                      
                    EXSO: 
                        begin
                            if ( !DP_Mode && !WIP && Chip_EN && ~HPM_RD ) begin
                                if ( CS_INT == 1'b1 && Bit == 7 ) begin  
                                    //$display( $time, " Enter EXSO  Function ..." );
                                    exit_secured_otp;
                                end
                                else if ( Bit > 7 )
                                    STATE <= `BAD_CMD_STATE;
                            end
                            else if ( Bit == 7 )
                                STATE <= `BAD_CMD_STATE;
                        end
                      
                    RDSCUR: 
                        begin
                            if ( !DP_Mode && Chip_EN && ~HPM_RD) begin 
                                // $display( $time, " Enter Read Secur_Register Function ..." );
                                Read_SHSL = 1'b1;
                                RDSCUR_Mode = 1'b1;
                            end
                            else if ( Bit == 7 )
                                STATE <= `BAD_CMD_STATE;                                
                        end
                      
                      
                    WRSCUR: 
                        begin
                            if ( !DP_Mode && !WIP && WEL && !Secur_Mode && Chip_EN && ~HPM_RD && !EPSUSP ) begin
                                if ( CS_INT == 1'b1 && Bit == 7 ) begin  
                                    //$display( $time, " Enter WRSCUR Secur_Register Function ..." );
                                    ->WRSCUR_Event;
                                end
                                else if ( Bit > 7 )
                                    STATE <= `BAD_CMD_STATE;
                            end
                            else if ( Bit == 7 )
                                STATE <= `BAD_CMD_STATE;
                        end

                    RDEAR: 
                        begin
                            if ( !DP_Mode && !WIP && Chip_EN && ~HPM_RD && !EPSUSP ) begin
                                // $display( $time, " Enter Read Extended_Address_Register Function ..." );
                                Read_SHSL = 1'b1;
                                RDEAR_Mode = 1'b1;
                            end
                            else if ( Bit == 7 )
                                STATE <= `BAD_CMD_STATE;                                
                        end

                    WREAR: 
                        begin
                            if ( !DP_Mode && !WIP && WEL && Chip_EN && ~HPM_RD && !EPSUSP ) begin
                                if ( CS_INT == 1'b1 && Bit == 15 ) begin  
                                    //$display( $time, " Enter WREAR Extended_Address_Register Function ..." );
                                    ->WREAR_Event;
                                end
                                else if ( CS_INT == 1'b1 && (Bit > 15 || Bit < 15) )
                                    STATE <= `BAD_CMD_STATE;
                            end
                            else if ( Bit == 7 )
                                STATE <= `BAD_CMD_STATE;
                        end

                      
                    READ4X:
                        begin
                            if ( !DP_Mode && !WIP && (Status_Reg[6]|ENQUAD) && Chip_EN && ~HPM_RD ) begin
                                //$display( $time, " Enter READX4 Function ..." );
                                Read_SHSL = 1'b1;
                                if ( (Bit == 13 && !CR[5] && !ENQUAD) || (Bit == 31 && !CR[5] && ENQUAD) || (Bit == 15 && CR[5] && !ENQUAD) || (Bit == 39 && CR[5] && ENQUAD) ) begin
                                    Address = SI_Reg [A_MSB:0];
                                    if ( !CR[5] ) begin
                                            Address [25:24] = EA_Reg[1:0];
                                    end
                                    load_address(Address);
                                end
                                Read_4XIO_Mode = 1'b1;
                                READ4X_Mode    = 1'b1;
                                READ4X_BOT_Mode    = 1'b1;
                            end
                            else if ( Bit == 7 )
                                STATE <= `BAD_CMD_STATE;                            

                        end


                    READ4X4B:
                        begin
                            if ( !DP_Mode && !WIP && (Status_Reg[6]|ENQUAD) && Chip_EN && ~HPM_RD ) begin
                                //$display( $time, " Enter READX4 Function ..." );
                                Read_SHSL = 1'b1;
                                if ( (Bit == 15 && !ENQUAD) || (Bit == 39 && ENQUAD) ) begin
                                    Address = SI_Reg [A_MSB:0];
                                    load_address(Address);
                                end
                                Read_4XIO_Mode = 1'b1;
                                READ4X4B_Mode    = 1'b1;
                                ADD_4B_Mode = 1'b1;
                            end
                            else if ( Bit == 7 )
                                STATE <= `BAD_CMD_STATE;                            

                        end

                    DREAD:
                        begin
                            if ( !DP_Mode && !WIP && Chip_EN && ~HPM_RD && !ENQUAD ) begin
                                //$display( $time, " Enter Fast Read dual output Function ..." );
                                Read_SHSL = 1'b1;
                                if ( (Bit == 31 && !CR[5]) || (Bit == 39 && CR[5]) ) begin
                                    Address = SI_Reg [A_MSB:0];
                                    if ( !CR[5] ) begin
                                            Address [25:24] = EA_Reg[1:0];
                                    end
                                    load_address(Address);
                                end
                                FastRD_2XIO_Mode =1'b1;
                            end
                            else if ( Bit == 7 )
                                STATE <= `BAD_CMD_STATE;                            
                        end

                    DREAD4B:
                        begin
                            if ( !DP_Mode && !WIP && Chip_EN && ~HPM_RD && !ENQUAD ) begin
                                //$display( $time, " Enter Fast Read dual output Function ..." );
                                Read_SHSL = 1'b1;
                                if ( Bit == 39 ) begin
                                    Address = SI_Reg [A_MSB:0];
                                    load_address(Address);
                                end
                                FastRD_2XIO_Mode =1'b1;
                                ADD_4B_Mode = 1'b1;
                            end
                            else if ( Bit == 7 )
                                STATE <= `BAD_CMD_STATE;                            
                        end

                    QREAD:
                        begin
                            if ( !DP_Mode && !WIP && Status_Reg[6] && Chip_EN  && ~HPM_RD && !ENQUAD ) begin
                                //$display( $time, " Enter Fast Read quad output Function ..." );
                                Read_SHSL = 1'b1;
                                if ( (Bit == 31 && !CR[5]) || (Bit == 39 && CR[5]) ) begin 
                                   Address = SI_Reg [A_MSB:0];
                                    if ( !CR[5] ) begin
                                            Address [25:24] = EA_Reg[1:0];
                                    end
                                   load_address(Address);
                                end
                                FastRD_4XIO_Mode =1'b1;
                            end
                            else if ( Bit == 7 )
                                STATE <= `BAD_CMD_STATE;
                        end

                    QREAD4B:
                        begin
                            if ( !DP_Mode && !WIP && Status_Reg[6] && Chip_EN  && ~HPM_RD && !ENQUAD ) begin
                                //$display( $time, " Enter Fast Read quad output Function ..." );
                                Read_SHSL = 1'b1;
                                if ( Bit == 39 ) begin 
                                   Address = SI_Reg [A_MSB:0];
                                   load_address(Address);
                                end
                                FastRD_4XIO_Mode =1'b1;
                                ADD_4B_Mode = 1'b1;
                            end
                            else if ( Bit == 7 )
                                STATE <= `BAD_CMD_STATE;
                        end

                    DDRREAD4X:
                        begin
                            if ( !DP_Mode && !WIP && (Status_Reg[6] | ENQUAD) && Chip_EN && ~HPM_RD ) begin
                                //$display( $time, " Enter DDR READX4 Function ..." );
                                if ( Bit == 7 ) begin
                                    DDRRead_4XIO_Mode = 1'b1;
                                    DDRRead_4XIO_ModeX = 1'b1;
                                    Read_SHSL = 1'b1;
                                end
                            end
                            else if ( Bit == 7 )
                                STATE <= `BAD_CMD_STATE;                            
                        end

                    DDRREAD4X4B:
                        begin
                            if ( !DP_Mode && !WIP && (Status_Reg[6] | ENQUAD) && Chip_EN && ~HPM_RD ) begin
                                //$display( $time, " Enter DDR READX4 Function ..." );
                                if ( Bit == 7 ) begin
                                    DDRRead_4XIO_Mode = 1'b1;
                                    DDRRead_4XIO_Mode_4B = 1'b1;
                                    ADD_4B_Mode = 1'b1;
                                    Read_SHSL = 1'b1;
                                end
                            end
                            else if ( Bit == 7 )
                                STATE <= `BAD_CMD_STATE;                            
                        end
                      
                    FIOPGM0: 
                        begin
                            if ( !DP_Mode && !WIP && WEL && Status_Reg[6] && Chip_EN && ~HPM_RD && !ENQUAD && !EPSUSP) begin
                                if ( (Bit == 13 && !CR[5]) || (Bit == 15 && CR[5]) ) begin
                                    Address = SI_Reg [A_MSB:0];
                                    if ( !CR[5] ) begin
                                            Address [25:24] = EA_Reg[1:0];
                                    end
                                    load_address(Address);
                                end
                                PP_4XIO_Load= 1'b1;
                                SO_IN_EN    = 1'b1;
                                SI_IN_EN    = 1'b1;
                                WP_IN_EN    = 1'b1;
                                SIO3_IN_EN  = 1'b1;
                                if ( CS_INT == 0 && ((Bit == 13 && !CR[5]) || (Bit == 15 && CR[5])) ) begin
                                    //$display( $time, " Enter 4io Page Program Function ..." );
                                    ->PP_Event;
                                    PP_4XIO_Mode= 1'b1;
                                end
                                else if ( CS_INT == 1 && (Bit < 15 || (Bit + 1)%2 !== 0 ) && !CR[5])begin
                                    STATE <= `BAD_CMD_STATE;
                                end
                                else if ( CS_INT == 1 && (Bit < 17 || (Bit + 1)%2 !== 0 ) && CR[5])begin
                                    STATE <= `BAD_CMD_STATE;
                                end    
                            end
                            else if ( Bit == 7 )
                                STATE <= `BAD_CMD_STATE;
                        end

                    FIOPGM04B: 
                        begin
                            if ( !DP_Mode && !WIP && WEL && Status_Reg[6] && Chip_EN && ~HPM_RD && !ENQUAD && !EPSUSP) begin
                                ADD_4B_Mode = 1'b1;
                                if ( Bit == 15 ) begin
                                    Address = SI_Reg [A_MSB:0];
                                    load_address(Address);
                                end
                                PP_4XIO_Load= 1'b1;
                                SO_IN_EN    = 1'b1;
                                SI_IN_EN    = 1'b1;
                                WP_IN_EN    = 1'b1;
                                SIO3_IN_EN  = 1'b1;
                                if ( CS_INT == 0 && Bit == 15 ) begin
                                    //$display( $time, " Enter 4io Page Program Function ..." );
                                    ->PP_Event;
                                    PP_4XIO_Mode= 1'b1;
                                end
                                else if ( CS_INT == 1 && (Bit < 17 || (Bit + 1)%2 !== 0 ) )begin
                                    STATE <= `BAD_CMD_STATE;
                                end    
                            end
                            else if ( Bit == 7 )
                                STATE <= `BAD_CMD_STATE;
                        end

                    EQIO:
                        begin
                            if ( !DP_Mode && !WIP && Chip_EN && ~HPM_RD && !ENQUAD ) begin
                                if ( CS_INT == 1'b1 && Bit == 7 ) begin
                                    //$display( $time, " Enable Quad I/O Function ..." );
                                    ENQUAD = 1'b1;
                                end
                                else if ( Bit > 7 )
                                    STATE <= `BAD_CMD_STATE;
                            end
                            else if ( Bit == 7 )
                                STATE <= `BAD_CMD_STATE;
                        end

                    RSTQIO:
                        begin
                            if ( !DP_Mode && !WIP && Chip_EN && ~HPM_RD && ENQUAD ) begin
                                if ( CS_INT == 1'b1 && Bit == 7 ) begin
                                    //$display( $time, " Exiting QPI mode ..." );
                                    ENQUAD = 1'b0;
                                end
                                else if ( Bit > 7 )
                                    STATE <= `BAD_CMD_STATE;
                            end
                            else if ( Bit == 7 )
                                STATE <= `BAD_CMD_STATE;
                        end

                    RSTEN:
                        begin
                            if ( Chip_EN ) begin
                                if ( CS_INT == 1'b1 && (Bit == 7 || (EN4XIO_Read_Mode && Bit == 1) || (ENDDR4XIO_Read_Mode && Bit == 1)) ) begin
                                    //$display( $time, " Reset enable ..." );
                                    ->RST_EN_Event;
                                end
                                else if ( Bit > 7 )
                                    STATE <= `BAD_CMD_STATE;
                            end
                            else if ( Bit == 7 )
                                STATE <= `BAD_CMD_STATE;
                        end

                    RST:
                        begin
                            if ( Chip_EN && RST_CMD_EN ) begin
                                if ( CS_INT == 1'b1 && (Bit == 7 || (EN4XIO_Read_Mode && Bit == 1) || (ENDDR4XIO_Read_Mode && Bit == 1)) ) begin
                                    //$display( $time, " Reset memory ..." );
                                    ->RST_Event;
                                end
                                else if ( Bit > 7 )
                                    STATE <= `BAD_CMD_STATE;
                            end
                            else if ( Bit == 7 )
                                STATE <= `BAD_CMD_STATE;
                        end

                    NOP:
                        begin
                        end

                    default: 
                        begin
                            STATE <= `BAD_CMD_STATE;
                        end
                    endcase
                end
                 
            `BAD_CMD_STATE: 
                begin
                end
            
            default: 
                begin
                STATE =  `STANDBY_STATE;
                end
        endcase

    end

    always @ (posedge CS_INT) begin
            RST_CMD_EN <= #1 1'b0;

            SIO0_Reg <= #tSHQZ 1'bx;
            SIO1_Reg <= #tSHQZ 1'bx;
            SIO2_Reg <= #tSHQZ 1'bx;
            SIO3_Reg <= #tSHQZ 1'bx;

            SIO0_Out_Reg <= #tSHQZ 1'bx;
            SIO1_Out_Reg <= #tSHQZ 1'bx;
            SIO2_Out_Reg <= #tSHQZ 1'bx;
            SIO3_Out_Reg <= #tSHQZ 1'bx;
           
            SO_OUT_EN    <= #tSHQZ 1'b0;
            SI_OUT_EN    <= #tSHQZ 1'b0;
            WP_OUT_EN    <= #tSHQZ 1'b0;
            SIO3_OUT_EN  <= #tSHQZ 1'b0;
            Prea_OUT_EN1     = 1'b0;
            Prea_OUT_EN2     = 1'b0;
            Prea_OUT_EN4     = 1'b0;

            #1;
            Bit         = 1'b0;
            Bit_Tmp     = 1'b0;
           
            SO_IN_EN    = 1'b0;
            SI_IN_EN    = 1'b0;
            WP_IN_EN    = 1'b0;
            SIO3_IN_EN  = 1'b0;

            RDID_Mode   = 1'b0;
            RDSR_Mode   = 1'b0;
            RDCR_Mode   = 1'b0;
            RDSCUR_Mode = 1'b0;
            RDLR_Mode   = 1'b0;
            RDFBR_Mode   = 1'b0;
            RDPASS_Mode   = 1'b0;
            RDDPB_Mode   = 1'b0;
            RDSPB_Mode   = 1'b0;
            RDEAR_Mode = 1'b0;
            Read_Mode   = 1'b0;
            RES_Mode    = 1'b0;
            REMS_Mode   = 1'b0;
            SFDP_Mode    = 1'b0;
            Read_1XIO_Mode  = 1'b0;
            Read_2XIO_Mode  = 1'b0;
            Read_4XIO_Mode  = 1'b0;
            Read_1XIO_Chk   = 1'b0;
            Read_2XIO_Chk   = 1'b0;
            Read_4XIO_Chk   = 1'b0;
            FastRD_1XIO_Mode= 1'b0;
            FastRD_1XIO_Chk = 1'b0;
            FastRD_2XIO_Mode= 1'b0;
            FastRD_2XIO_Chk = 1'b0;
            FastRD_4XIO_Mode= 1'b0;
            FastRD_4XIO_Chk = 1'b0;
            PP_4XIO_Load    = 1'b0;
            PP_4XIO_Chk     = 1'b0;
            DDRRead_4XIO_Mode   = 1'b0;
            DDR_Read_Mode_IN    = 1'b0;
            STATE <=  `STANDBY_STATE;

            if( Chip_EN ) begin
                EN_Boot     = 1'b0;
            end
            FAST_BOOT_Mode  = 1'b0;
            FAST_BOOT_Chk   = 1'b0;

            ADD_4B_Mode = 1'b0;

            disable read_id;
            disable read_status;
            disable read_cr;
            disable read_Secur_Register;
            disable read_EA_Register;
            disable read_lock_register;
            disable read_FB_register;
            disable read_password_register;
            disable read_dpb_register;
            disable fast_boot_read;
            disable read_spb_register;
            disable read_1xio;
            disable read_2xio;
            disable read_4xio;
            disable ddrread_4xio;
            disable fastread_1xio;
            disable fastread_2xio;
            disable fastread_4xio;
            disable read_electronic_id;
            disable read_electronic_manufacturer_device_id;
            disable read_function;
            disable dummy_cycle;
        end

    always @ (posedge CS_INT) begin 

        if ( Set_4XIO_Enhance_Mode) begin
            EN4XIO_Read_Mode = 1'b1;
        end
        else if ( Set_4XIO_DDR_Enhance_Mode) begin
            ENDDR4XIO_Read_Mode = 1'b1;
        end
        else begin
            EN4XIO_Read_Mode = 1'b0;
            ENDDR4XIO_Read_Mode = 1'b0;
            DDRRead_4XIO_Mode = 1'b0;
            DDRRead_4XIO_ModeX = 1'b0;
            DDRRead_4XIO_Mode_4B = 1'b0;
            READ4X4B_Mode    = 1'b0;
            READ4X_Mode    = 1'b0;
            READ4X_BOT_Mode    = 1'b0;
        end
    end 

    always @ (posedge CS_INT) begin
        #tPGBUF_RST Pagebuf_Rst = 1'b0;
    end

    always @ (posedge CS_INT) begin
        #tCEH;
        #0;
        if ( Pagebuf_Rst ) begin
            for (i = 0; i < Buffer_Num; i = i + 1 ) begin
                Dummy_A[i]  = 8'hff;
            end
        end
    end

    always @ ( negedge Prea_OUT_EN1 or negedge Prea_OUT_EN2 or negedge Prea_OUT_EN4 ) begin
        #tCLQV;
        if ( !Prea_OUT_EN1 && !Prea_OUT_EN2 && !Prea_OUT_EN4 ) begin
                disable preamble_bit_out;
                disable preamble_bit_out_dtr;
        end
    end

    always @ ( posedge DDRRead_4XIO_Mode_4B ) begin
        DDRRead_4XIO_ModeX = 1'b0;
    end

    /*----------------------------------------------------------------------*/
    /*  ALL function trig action                                            */
    /*----------------------------------------------------------------------*/
    always @ ( posedge Read_1XIO_Mode
            or posedge FastRD_1XIO_Mode
            or posedge REMS_Mode
            or posedge RES_Mode
            or posedge Read_2XIO_Mode
            or posedge Read_4XIO_Mode 
            or posedge PP_4XIO_Load
            or posedge FastRD_2XIO_Mode
            or posedge FastRD_4XIO_Mode
           ) begin:read_function 
        wait ( SCLK == 1'b0 );
        if ( Read_1XIO_Mode == 1'b1 ) begin
            Read_1XIO_Chk = 1'b1;
            read_1xio;
        end
        else if ( FastRD_1XIO_Mode == 1'b1 ) begin
            FastRD_1XIO_Chk = 1'b1;
            fastread_1xio;
        end
        else if ( FastRD_2XIO_Mode == 1'b1 ) begin
            FastRD_2XIO_Chk = 1'b1;
            fastread_2xio;
        end
        else if ( FastRD_4XIO_Mode == 1'b1 ) begin
            FastRD_4XIO_Chk = 1'b1;
            fastread_4xio;
        end
        else if ( REMS_Mode == 1'b1 ) begin
            read_electronic_manufacturer_device_id;
        end 
        else if ( RES_Mode == 1'b1 ) begin
            read_electronic_id;
        end
        else if ( Read_2XIO_Mode == 1'b1 ) begin
            Read_2XIO_Chk = 1'b1;
            read_2xio;
        end
        else if ( Read_4XIO_Mode == 1'b1 ) begin
            Read_4XIO_Chk = 1'b1;
            read_4xio;
        end   
        else if ( PP_4XIO_Load == 1'b1 ) begin
            PP_4XIO_Chk = 1'b1;
        end
    end

    always @ ( posedge DDRRead_4XIO_Mode ) begin
        ddrread_4xio;
    end

    always @ ( posedge FAST_BOOT_Mode ) begin
            FAST_BOOT_Chk = 1'b1;
            fast_boot_read;
    end

    always @ ( RST_EN_Event ) begin
        RST_CMD_EN = #2 1'b1;
    end
    
    always @ ( RST_Event ) begin
        During_RST_REC = 1;
        if ((WRSR_Mode||WRSR2_Mode) && (tWRSR==tW||tWRSR==tBP)) begin
            #(tREADY2_W);
        end
        else if ( WR_WPSEL_Mode || WRLR_Mode || WRPASS_Mode || WRFBR_Mode || PASSULK_Mode || WRSPB_Mode || WRSCUR_Mode ||  PP_4XIO_Mode || PP_1XIO_Mode ) begin
            #(tREADY2_P);
        end
        else if ( SE_4K_Mode || ESSPB_Mode || ESFBR_Mode ) begin
            #(tREADY2_SE);
        end
        else if ( BE64K_Mode || BE32K_Mode ) begin
            #(tREADY2_BE);
        end
        else if ( CE_Mode ) begin
            #(tREADY2_CE);
        end
        else if ( DP_Mode == 1'b1 ) begin
            #(tRES2);
        end
        else if ( Read_SHSL == 1'b1 ) begin
            #(tREADY2_R);
        end
        else begin
            #(tREADY2_D);
        end

        disable write_status;
        disable write_lock_register;
        disable write_password_register;
        disable write_FB_register;
        disable write_dpb_register;
        disable erase_FB_register;
        disable chip_lock;
        disable chip_unlock;
        disable read_FB_register;
        disable read_password_register;
        disable read_dpb_register;
        disable program_spb_register;
        disable erase_spb_register;
        disable write_protection_select;
        disable block_erase_32k;
        disable block_erase;
        disable sector_erase_4k;
        disable chip_erase;
        disable page_program; // can deleted
        disable update_array;
        disable read_Secur_Register;
        disable read_EA_Register;
        disable write_secur_register;
        disable write_ea_register;
        disable read_id;
        disable read_status;
        disable read_cr;
        disable read_lock_register;
        disable read_spb_register;
        disable suspend_write;
        disable resume_write;
        disable er_timer;
        disable pg_timer;
        disable stimeout_cnt;
        disable rtimeout_cnt;

        disable read_1xio;
        disable read_2xio;
        disable read_4xio;
        disable ddrread_4xio;
        disable fastread_1xio;
        disable fastread_2xio;
        disable fastread_4xio;
        disable read_electronic_id;
        disable read_electronic_manufacturer_device_id;
        disable read_function;
        disable dummy_cycle;

        disable fast_boot_read;

        reset_sm;
        Status_Reg[1:0] = 2'b0;
        Secur_Reg[6:2]  = 5'b0;

        CR[2:0]         = 3'b111;
        CR[4]           = 1'b0;
        CR[5]           = 1'b0;
        CR[7:6]         = 2'b00;

    end

// *==============================================================================================
// * Hardware Reset Function description
// * =============================================================================================
    always @ ( negedge RESETB_INT ) begin
        if (RESETB_INT == 1'b0) begin
            disable hd_reset;
            #0;
            -> HDRST_Event;
        end
    end
    always @ ( HDRST_Event ) begin: hd_reset
      if (RESETB_INT == 1'b0) begin
        During_RST_REC = 1;
        if ((WRSR_Mode||WRSR2_Mode) && (tWRSR==tW||tWRSR==tBP)) begin
            #(tREADY2_W);
        end
        else if ( WR_WPSEL_Mode || WRLR_Mode || WRPASS_Mode || WRFBR_Mode || PASSULK_Mode || WRSPB_Mode || WRSCUR_Mode ||  PP_4XIO_Mode || PP_1XIO_Mode ) begin
            #(tREADY2_P);
        end
        else if ( SE_4K_Mode || ESSPB_Mode || ESFBR_Mode ) begin
            #(tREADY2_SE);
        end
        else if ( BE64K_Mode || BE32K_Mode ) begin
            #(tREADY2_BE);
        end
        else if ( CE_Mode ) begin
            #(tREADY2_CE);
        end
        else if ( DP_Mode == 1'b1 ) begin
            #(tRES2+tRLRH);
        end
        else if ( Read_SHSL == 1'b1 ) begin
            #(tREADY2_R);
        end
        else begin
            #(tREADY2_D);
        end

        disable write_status;
        disable write_lock_register;
        disable write_password_register;
        disable write_FB_register;
        disable write_dpb_register;
        disable erase_FB_register;
        disable chip_lock;
        disable chip_unlock;
        disable read_FB_register;
        disable read_password_register;
        disable read_dpb_register;
        disable program_spb_register;
        disable erase_spb_register;
        disable write_protection_select;
        disable block_erase_32k;
        disable block_erase;
        disable sector_erase_4k;
        disable chip_erase;
        disable page_program; // can deleted
        disable update_array;
        disable read_Secur_Register;
        disable read_EA_Register;
        disable write_secur_register;
        disable write_ea_register;
        disable read_id;
        disable read_status;
        disable read_cr;
        disable read_lock_register;
        disable read_spb_register;
        disable suspend_write;
        disable resume_write;
        disable er_timer;
        disable pg_timer;
        disable stimeout_cnt;
        disable rtimeout_cnt;

        disable read_1xio;
        disable read_2xio;
        disable read_4xio;
        disable fast_boot_read;
        disable ddrread_4xio;
        disable fastread_1xio;
        disable fastread_2xio;
        disable fastread_4xio;
        disable read_electronic_id;
        disable read_electronic_manufacturer_device_id;
        disable read_function;
        disable dummy_cycle;

        reset_sm;
        Status_Reg[1:0] = 2'b0;
        Secur_Reg[6:2]  = 5'b0;
        CR[2:0]         = 3'b111;
        CR[4]           = 1'b0;
        CR[5]           = 1'b0;
        CR[7:6]         = 2'b00;
      end
    end

    always @ ( posedge Susp_Trig ) begin:stimeout_cnt
        Susp_Trig <= #1 1'b0;
    end

    always @ ( posedge Resume_Trig ) begin:rtimeout_cnt
        Resume_Trig <= #1 1'b0;
    end


    always @ ( posedge READ4X4B_Mode ) begin
        READ4X_Mode = 1'b0;
    end


    always @ ( WRSR_Event ) begin
        write_status;
    end

    always @ ( WRLR_Event ) begin
        write_lock_register;
    end

    always @ ( WRPASS_Event ) begin
        write_password_register;
    end

    always @ ( WRFBR_Event ) begin
        write_FB_register;
    end

    always @ ( PASSULK_Event ) begin
        password_unlock;
    end

    always @ ( WRSPB_Event ) begin
        program_spb_register;
    end

    always @ ( ESSPB_Event ) begin
        erase_spb_register;
    end

    always @ ( ESFBR_Event ) begin
        erase_FB_register;
    end

    always @ ( WRDPB_Event ) begin
        write_dpb_register;
    end

    always @ ( BE_Event ) begin
        block_erase;
    end

    always @ ( CE_Event ) begin
        chip_erase;
    end
    
    always @ ( PP_Event ) begin:page_program_mode
        page_program( Address );
    end
   
    always @ ( SE_4K_Event ) begin
        sector_erase_4k;
    end

    always @ ( posedge RDID_Mode ) begin
        read_id;
    end

    always @ ( posedge RDSR_Mode ) begin
        read_status;
    end

    always @ ( posedge RDCR_Mode ) begin
        read_cr;
    end

    always @ ( posedge RDSCUR_Mode ) begin
        read_Secur_Register;
    end

    always @ ( posedge RDLR_Mode ) begin
        read_lock_register;
    end

    always @ ( posedge RDFBR_Mode ) begin
        read_FB_register;
    end

    always @ ( posedge RDPASS_Mode ) begin
        read_password_register;
    end

    always @ ( posedge RDDPB_Mode ) begin
        read_dpb_register;
    end

    always @ ( posedge RDSPB_Mode ) begin
        read_spb_register;
    end

    always @ ( WRSCUR_Event ) begin
        write_secur_register;
    end

    always @ ( Susp_Event ) begin
        suspend_write;
    end

    always @ ( Resume_Event ) begin
        resume_write;
    end

    always @ ( posedge RDEAR_Mode ) begin
        read_EA_Register;
    end

    always @ ( WREAR_Event ) begin
        write_ea_register;
    end

    always @ ( BE32K_Event ) begin
        block_erase_32k;
    end


    always @ ( GBLK_Event ) begin
        chip_lock;
    end

    always @ ( GBULK_Event ) begin
        chip_unlock;
    end

    always @ ( WPSEL_Event ) begin
        write_protection_select;
    end
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
