ricynlee/femto/(commit log)

2021-12-04 Major updates - Bugfixes - Speed updated from 12MHz to 24MHz - All new QSPINOR
    [MX25U51245G.v, clk_gen.v, clk_gen_clk_wiz.v]
2021-12-18 Minor bugfix on button_deglicher/reset
    [simtop.sv, wrapper.v]
2022-03-04 Start to introduce interrupt mechanism
2022-03-06 Only external interrupts out of traps are to be implemented. Interrupt-jump mechanism starts to work.
2022-03-13 Pipeline stage 1 (ID) updated for MRET support
2022-03-23 Interrupt support is almost implemented
2022-03-23 Setup simulation env for interrupt SoC UT & bugfix in femto top
    [MX25U51245G.v, core.v, dpinor.sv, femto.v, qpinor.sv, simtop.sv, sram.sv, uart_host.sv]
2022-03-27 Interrupt feature verified: successional & nested interrupts
2022-03-27 Bugfix Single/successional/nested interrupt verified Only mcause/mtvec/mepc/mip CSRs supported RST controller simplified
    [core.v, femto.v, main.c, rst.v]
2022-03-30 EIC & Interrupt verified
2022-04-03 all int main func changed to void int improve interrupt ut_soc test cases update sdk to match new RST logic RST module bugfix RST module updated to record previous reset cause
    [femto.v, main.c, rst.v, simtop.sv]
2022-04-03 RST module triggers SoC reset upon fault
    [rst.v]
2022-04-03 update RST test case
2022-04-05 Update timer/uart reg interface and interrupt triggers
2022-04-06 Update UART controller to support interrupt
2022-04-06 update SDK for UART/TIMER interrupt
2022-04-23 Block design mode (schematics) applied
2022-04-24 Fix block design generated hdl
    [bus_conn.py, dbus_conn.v, fault_encoder.v, femto.v, ibus_conn.v, pbus_conn.v]
2022-05-06 Major update - RTL fault_encoder bugfix - RTL sim env updated - SRC header updated - SRC default weak interrupt handler added - SRC ut header updated - SRC ut cases bugfix
    [fault_encoder.v, main.c]
2022-05-06 RST module & SDK bugfix
    [rst.v]
2022-07-15 Dir name changed preventing confusion
    [bus_primitive.v, core.v, dbgtcm.v, dbgtcm_wrapper.v, dbus_conn.v, dm.v, eic.v, eic_wrapper.v]
2022-07-25 Rewriting ID stage
2022-08-30 Pipeline stage (S2) opcode updated (in progress)
2022-10-21 Make sure jmp_addr is 2-aligned Add missing hwrite signal Add key comments
    [ibusif.sv]
2022-10-22 Optimization & Add missing hwrite
    [ibusif.sv, tb_ibusif.sv]
2023-03-05 TODO: put pipeline ctrl out of stages if & id
2023-03-12 ID stage updated
